pfeuh/yass/doc/electronicCao/docs/boite/yass_box.jpg

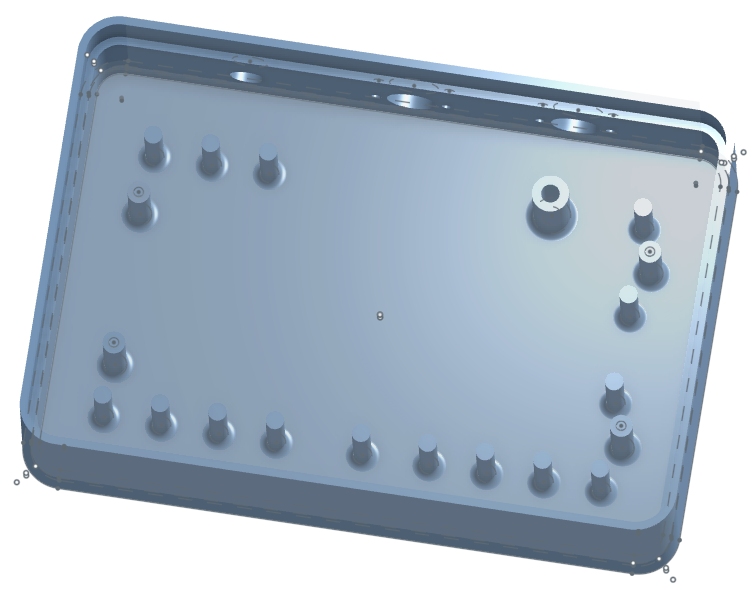
doc/electronicCao/docs/boite/yass_box.jpg
