pfeuh/yass/doc/img/yassWhiteFace.JPG

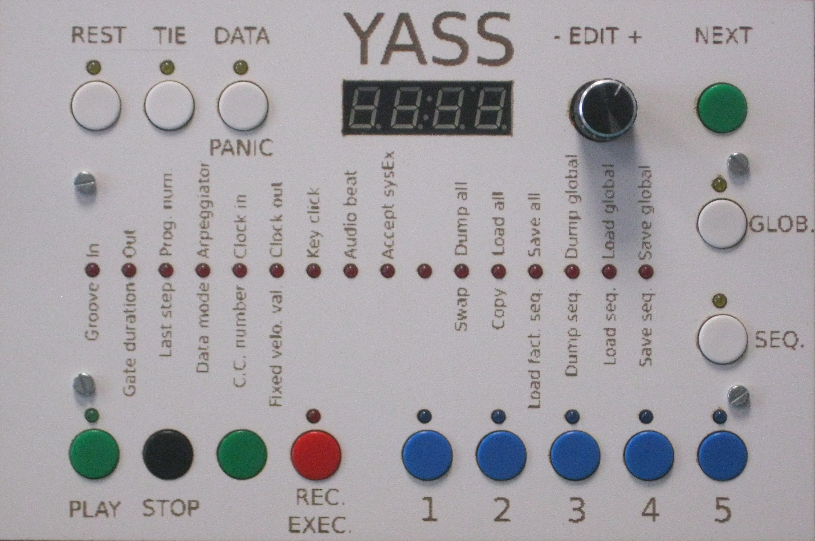
doc/img/yassWhiteFace.JPG
