pfeuh/yass/doc/readme.txt

Concerning Yass, all is shared.

Box data is explaned in yassBox.txt.
Schematic is in this folder.
To make the PCB, data is in fab folder.
