pfeuh/yass/doc/configuration.pdf

configuration

Page 1

| FONCTION | RANGE
GLOBAL | 1 In
| 2 Out
| 3

### 4 Off-On 5 Off-On 6 Off-On 7 Off-On 8 Off-On

| 9 Use exclusive | Off-On
| 10
| 11
| 12
| 13
| 14
| 15
| 16
SEQUENCE | 1 Groove | [1:7]
2 [1:3]
3 [1-16]
| 4 Data mode | [1-3]
| 5
| 6
| 7
| 8
| 9
| 10
11 [1:5]
| 12 Swap | [1:5]
| 13
14 [1:5]
15 [1:5]
16 [1:5]

Mode DEBUG

omni-[1 :16]
[1 :16]
Program number | [0 :127]-none
Sequencer/Arpeggiator
Clock in
Clock out
Key echo
Click
Dump project | work area or [1:xx]
Load project | work area or [1:xx]
Save project | work area or [1:xx]

Gate mode
Last step
Control change number | [1 :127]
Fixed velocity value | [1 :127]

Copy

Load from factory | [1:xx]
Dump sequence
Load sequence
Save sequence

Return to factory

configuration

Page 2

COMMENT

4, 8, 8t, 8 swing, 16, 16t, 16swing

Démarrer avec seq1 et seq5 appuyés

Number of projets not known at the moment Number of projets not known at the moment Number of projets not known at the moment

Short, regular, long

velocity, control change, fixed velocity

Destination value is memorized for next call Destination value is memorized for next call
xx depends on how many sequences are in ROM default value of selector is current sequence number default value of selector is current sequence number default value of selector is current sequence number

Démarrer avec seq 4 et seq5 appuyés
