pfeuh/yass/doc/electronicCao/boite/fixation face avant.pdf

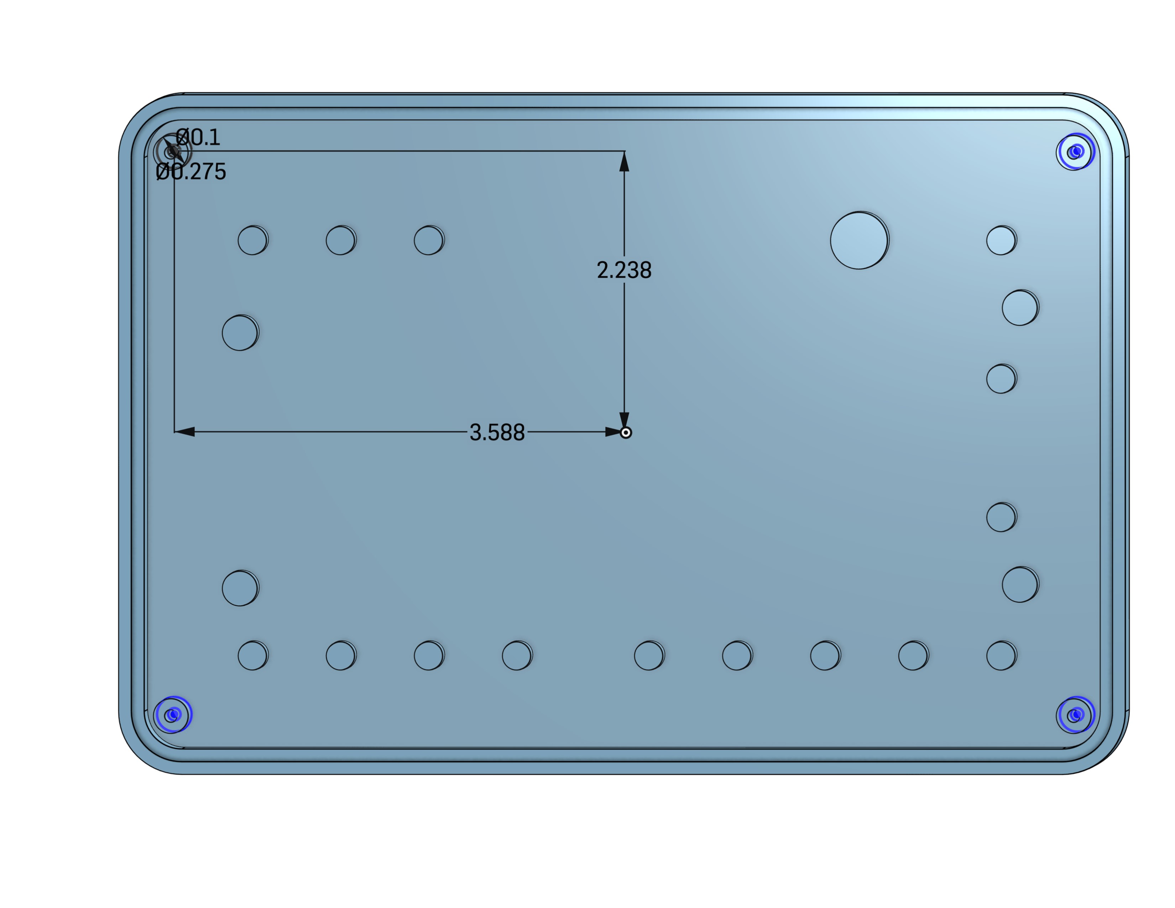
[picture p4: page 1]
