pfeuh/yass/doc/electronicCao/boite/fond.pdf

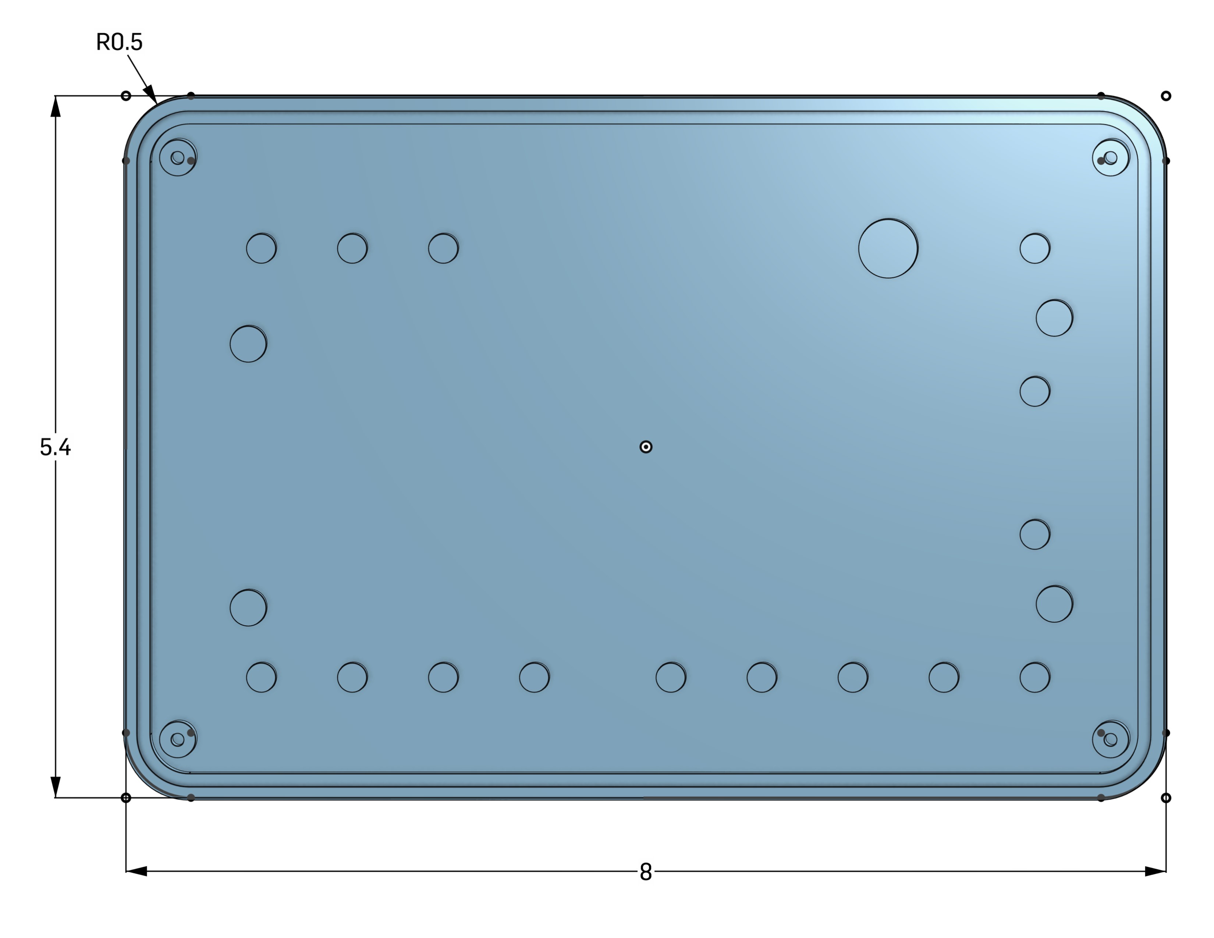
[picture p5: page 1]
