pfeuh/yass/doc/electronicCao/boite/supports_boutons.pdf

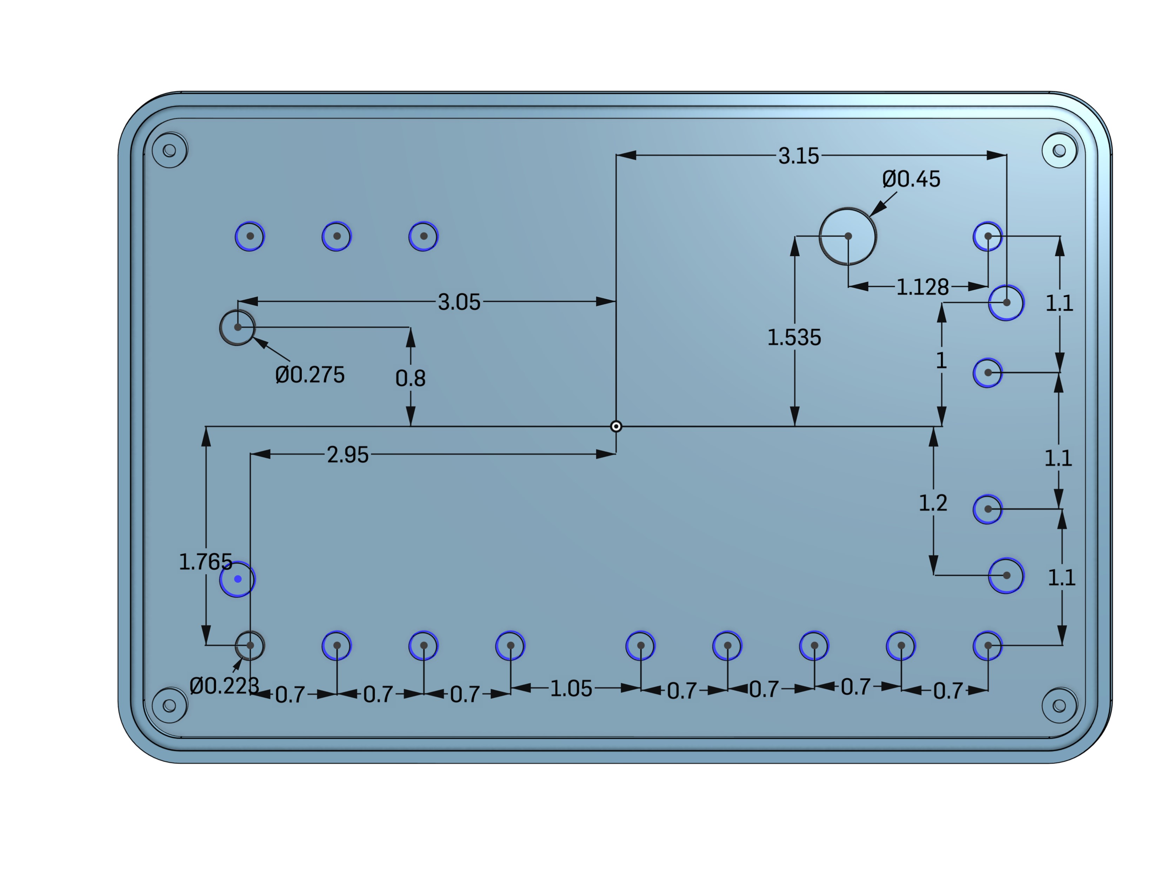
[picture p6: page 1]
