pfeuh/yass/doc/electronicCao/boite/bottom/dimensions.pdf

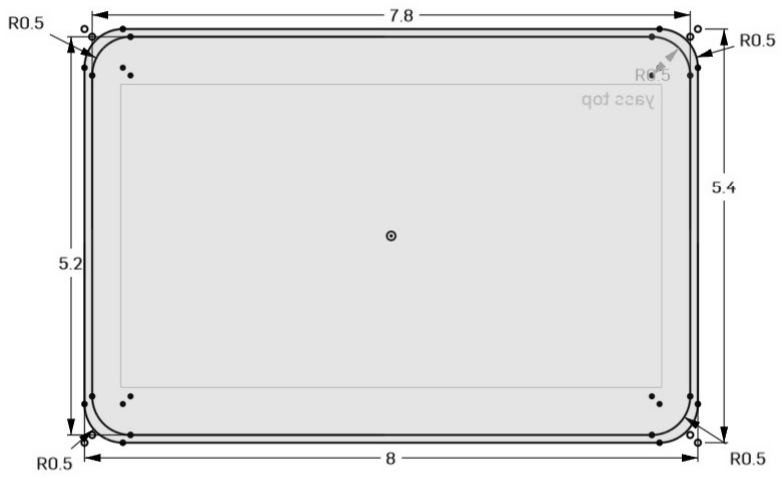
[picture p7: figure]
