pfeuh/yass/doc/electronicCao/boite/bottom/yass_bottom_cotes.pdf

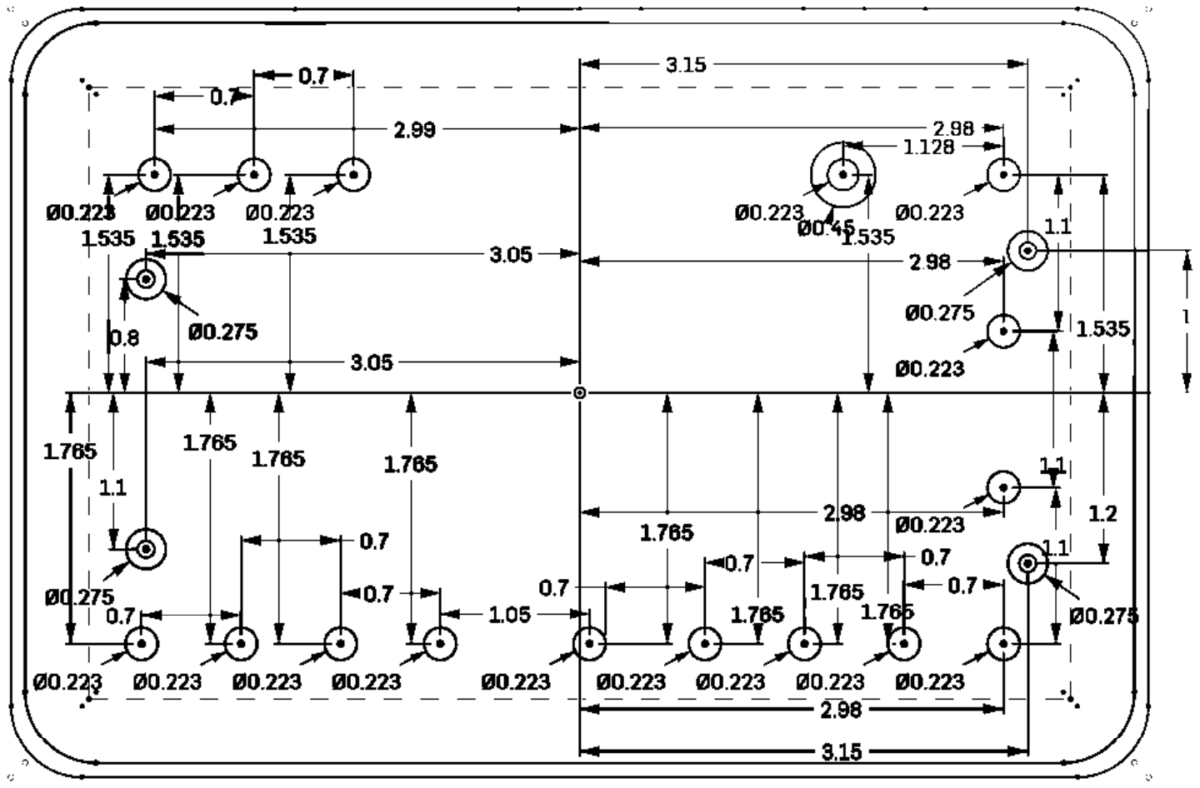
[picture p8: page 1]
