pfeuh/yass/doc/electronicCao/boite/key/main.pdf

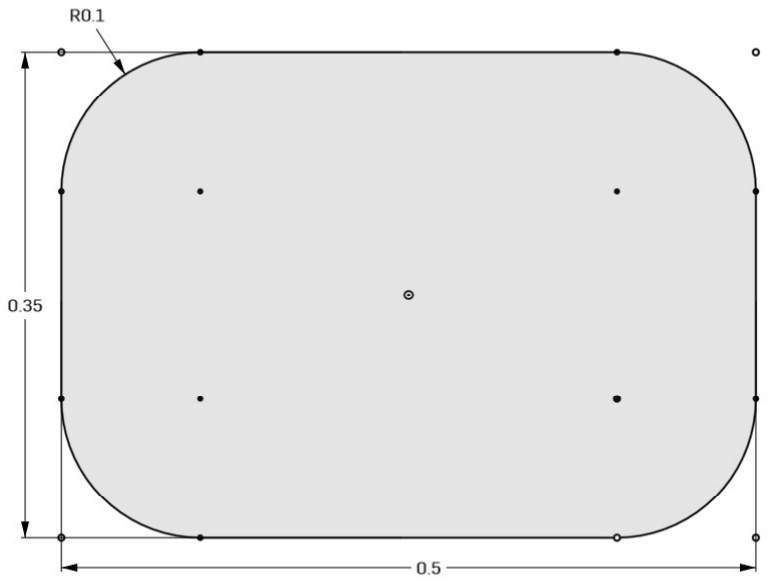
[picture p9: figure]
