pfeuh/yass/doc/electronicCao/boite/key/support.pdf

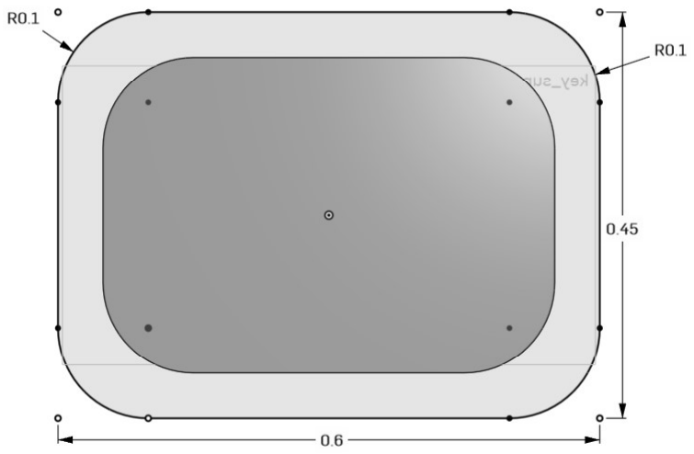
[picture p10: figure]
