pfeuh/yass/doc/electronicCao/boite/bottom/Image1.bmp

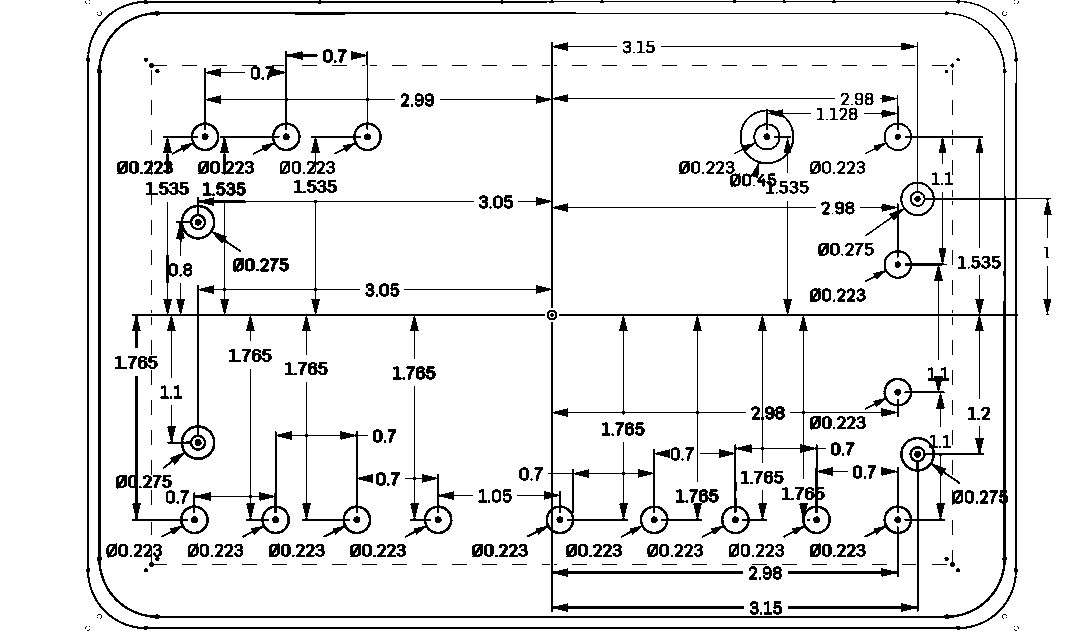
doc/electronicCao/boite/bottom/Image1.bmp
