pfeuh/yass/doc/electronicCao/boite/key/main.bmp

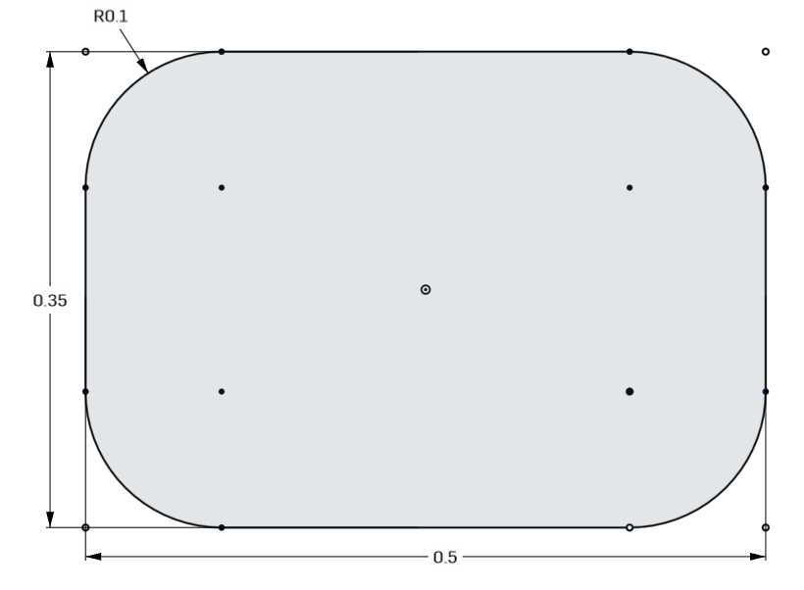
doc/electronicCao/boite/key/main.bmp
