pfeuh/yass/doc/electronicCao/boite/key/support.bmp

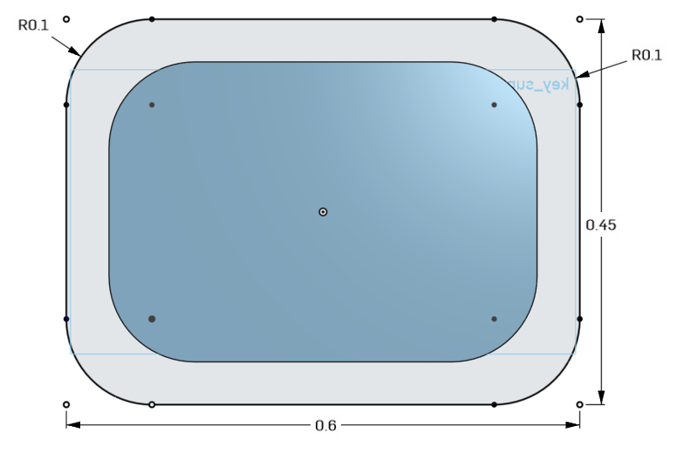
doc/electronicCao/boite/key/support.bmp
