pfeuh/yass/doc/electronicCao/docs/boite/yass_buttons.jpg

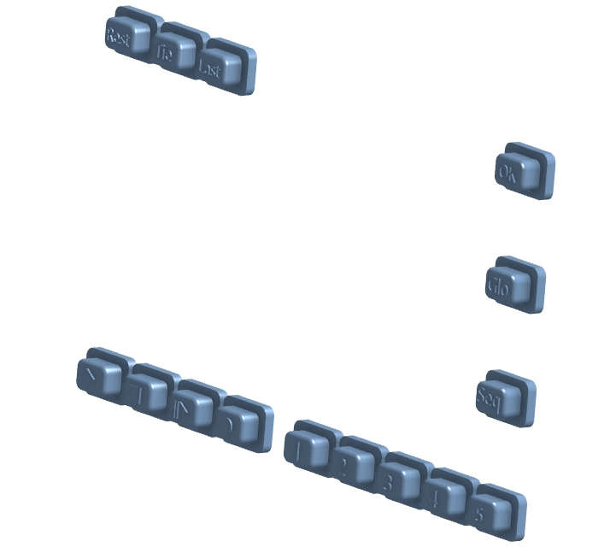
doc/electronicCao/docs/boite/yass_buttons.jpg
