pfeuh/yass/doc/electronicCao/docs/boite/yass_front_pannel.jpg

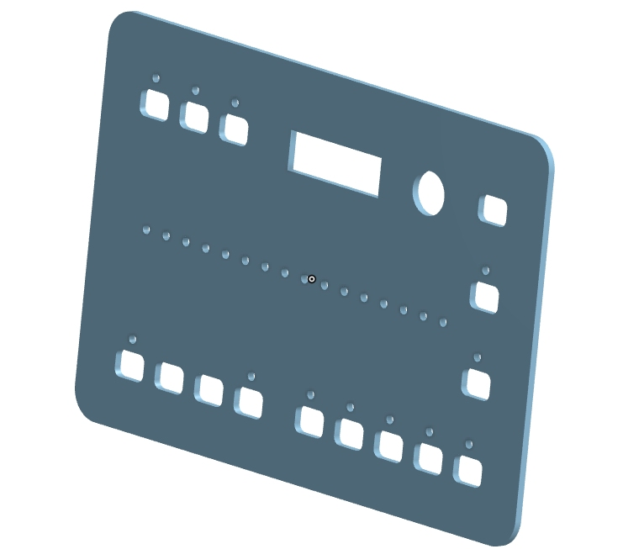
doc/electronicCao/docs/boite/yass_front_pannel.jpg
