pfeuh/yass/doc/frontPannel/inkscapeSvgcode/finalSeriagraphie.png

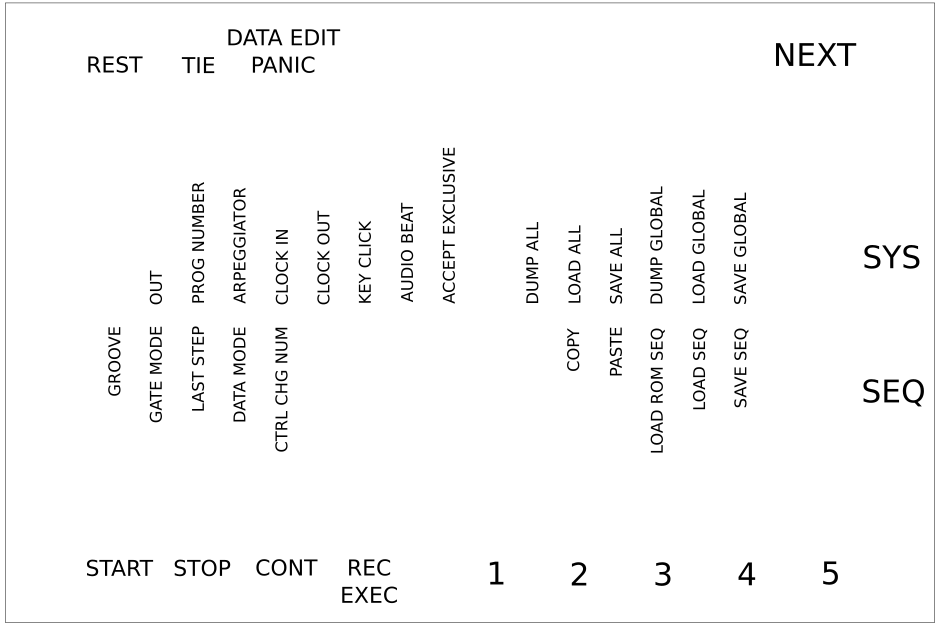
doc/frontPannel/inkscapeSvgcode/finalSeriagraphie.png
