pfeuh/yass/doc/frontPannel/scriptSvg/img/panneauDeControle.bmp

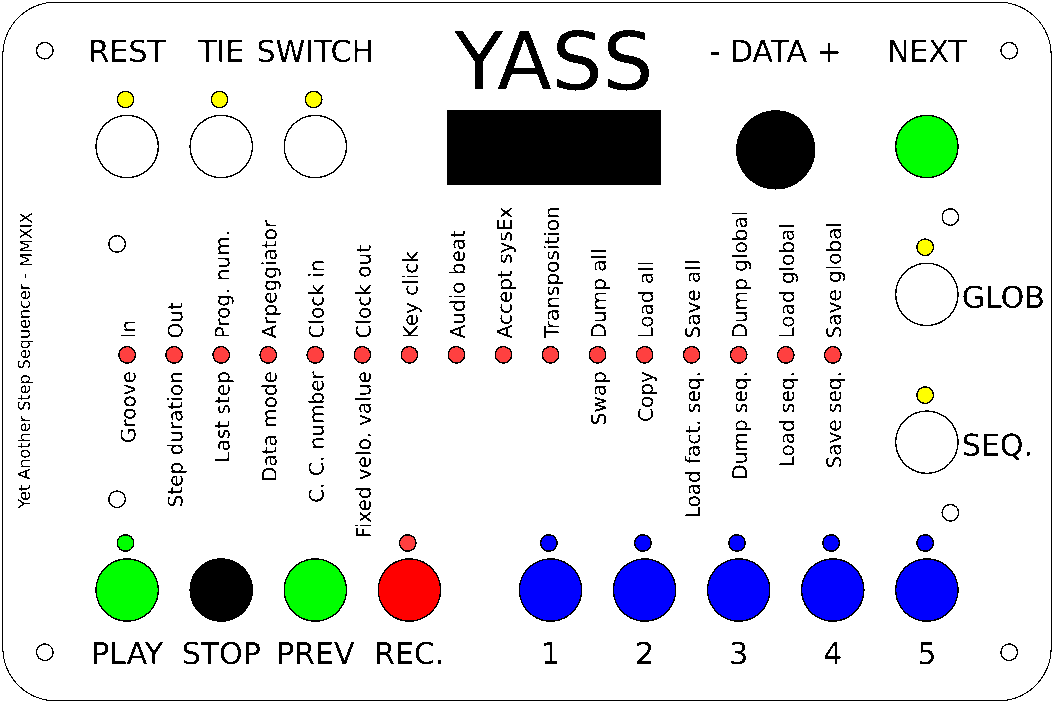
doc/frontPannel/scriptSvg/img/panneauDeControle.bmp
