pfeuh/yass/doc/frontPannel/simulation/img/yass_pannel.gif

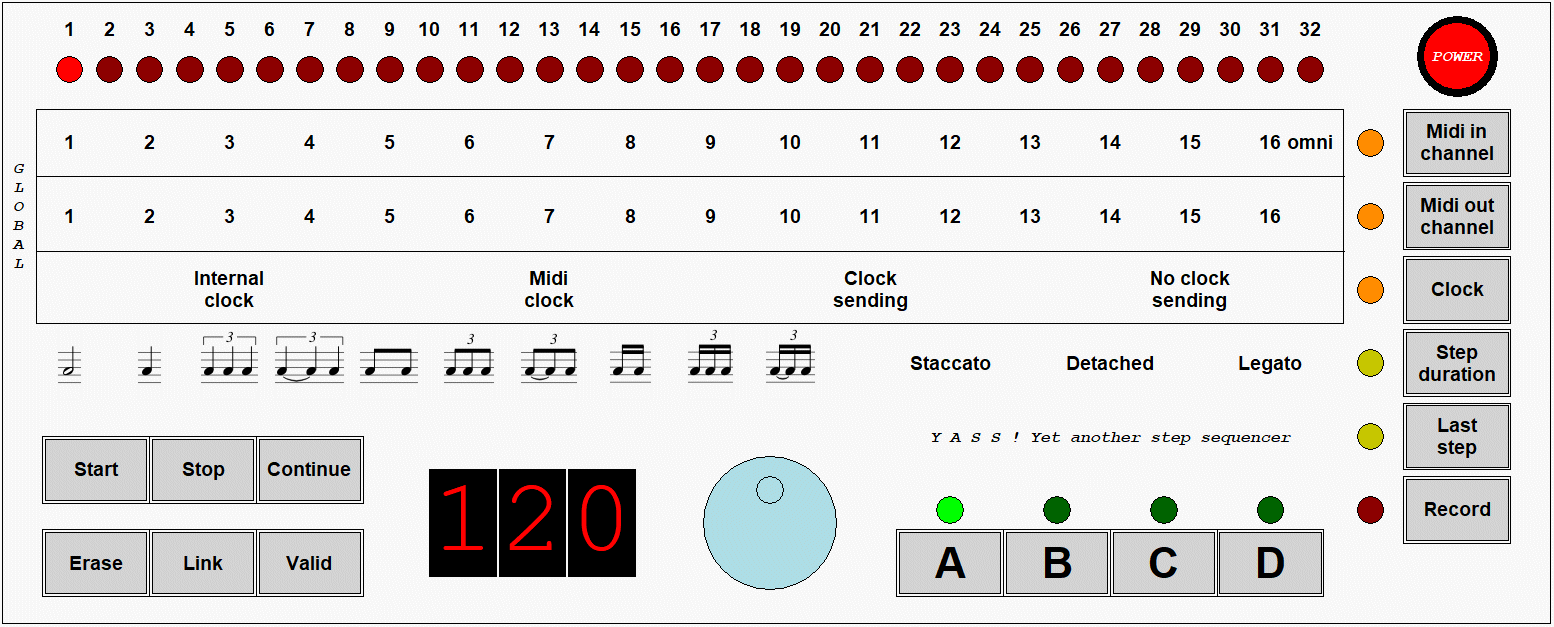
doc/frontPannel/simulation/img/yass_pannel.gif
