pfeuh/yass/doc/frontPannel/simulation/img/yassFrontPanel.jpg

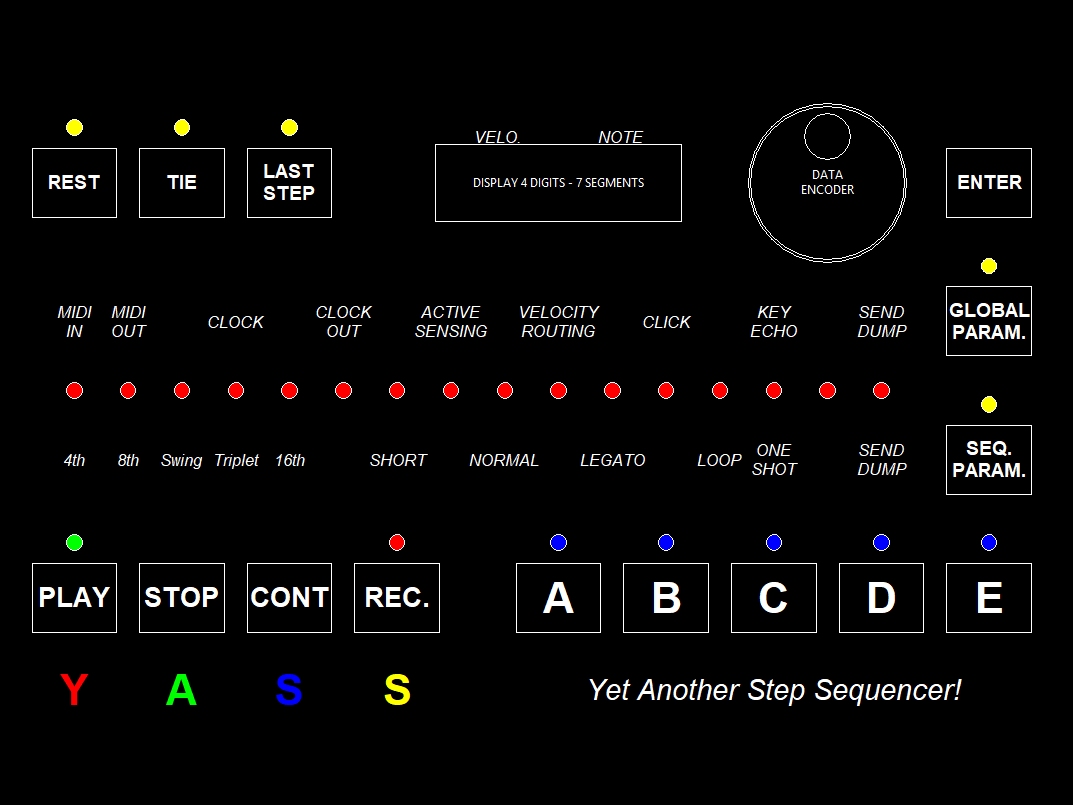
doc/frontPannel/simulation/img/yassFrontPanel.jpg
