pfeuh/yass/doc/3D_objects/yassBoxV2.stl

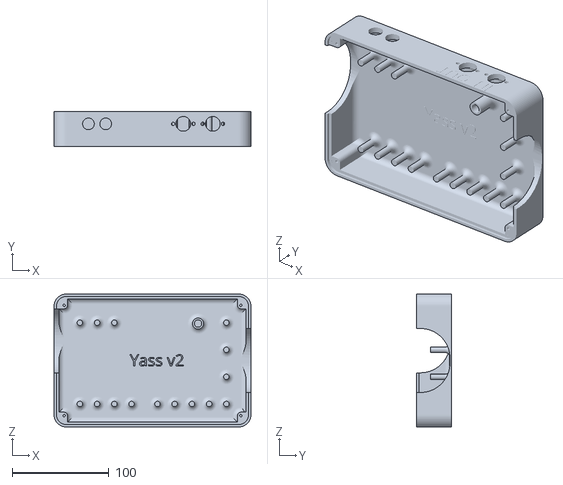
[picture p20: CAD file, 2019-09-08]
doc/3D_objects/yassBoxV2.stl
203.2 x 36.0 x 137.2
