pfeuh/yass/doc/electronicCao/boite/yass_box_bottom.stl

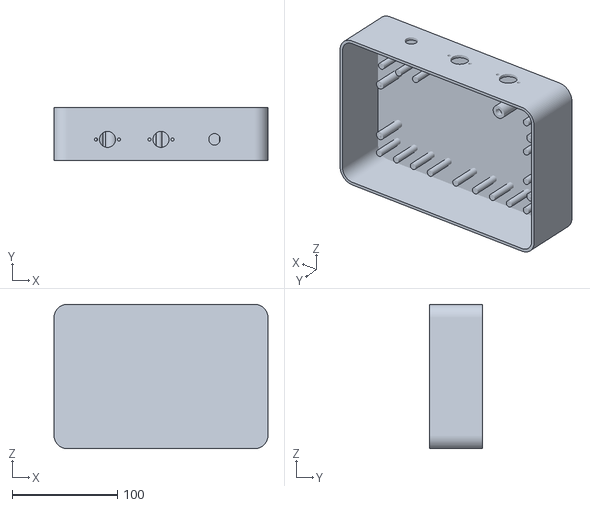
[picture p21: CAD file, 2019-09-05]
doc/electronicCao/boite/yass_box_bottom.stl
203.2 x 50.8 x 137.2
