pfeuh/yass/doc/electronicCao/docs/boite/yass_key.stl

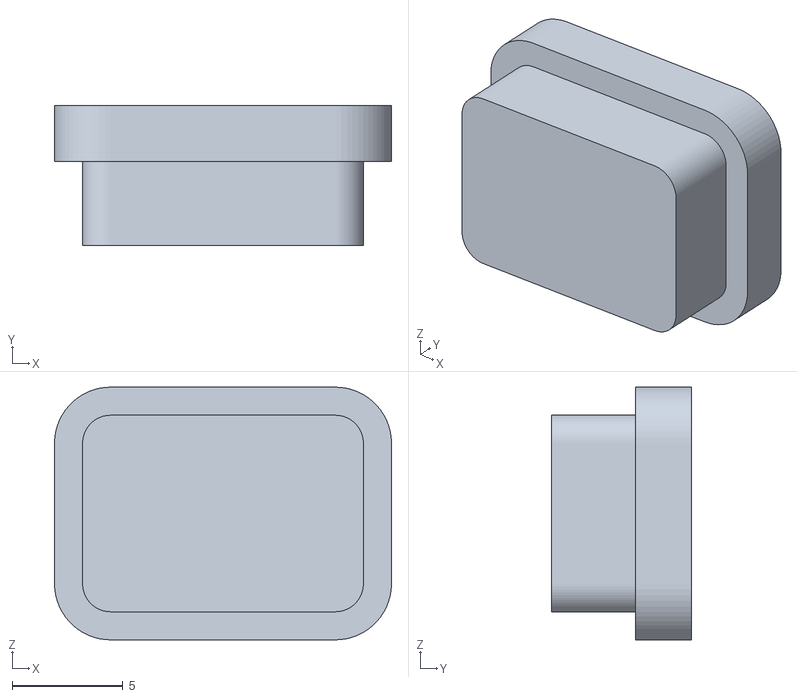
[picture p22: CAD file, 2019-09-05]
doc/electronicCao/docs/boite/yass_key.stl
15.2 x 6.35 x 11.4
