pfeuh/yass/doc/3D_objects/yassFrontPannelV2.stl

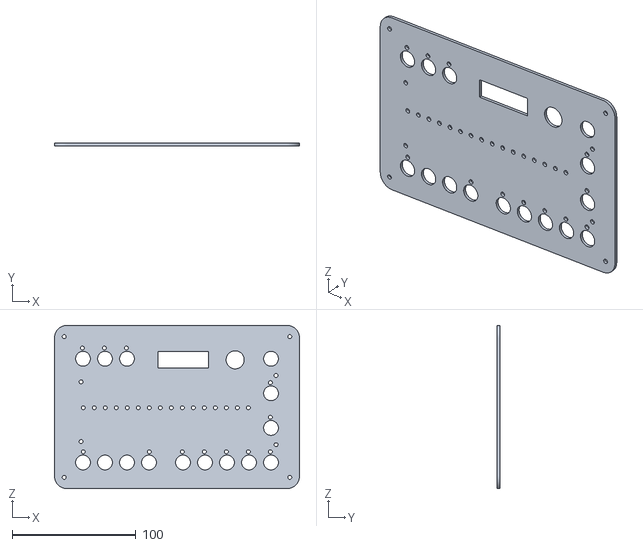
[picture p23: CAD file, 2019-09-08]
doc/3D_objects/yassFrontPannelV2.stl
197.9 x 2.03 x 131.9
