pfeuh/yass/doc/electronicCao/docs/boite/yass_box_top.stl

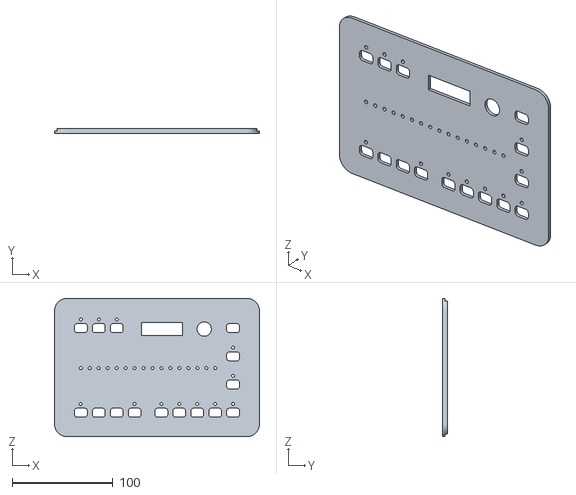
[picture p24: CAD file, 2019-09-05]
doc/electronicCao/docs/boite/yass_box_top.stl
203.2 x 5.08 x 137.2
