pfeuh/yass/doc/3D_objects/yassEntretoises.stl

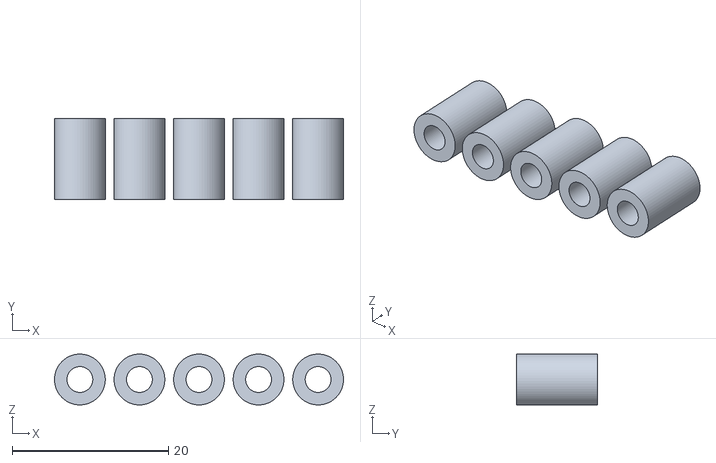
[picture p25: CAD file, 2019-09-05]
doc/3D_objects/yassEntretoises.stl
37.0 x 10.4 x 6.50
