pfeuh/yass/doc/3D_objects/yassTails.stl

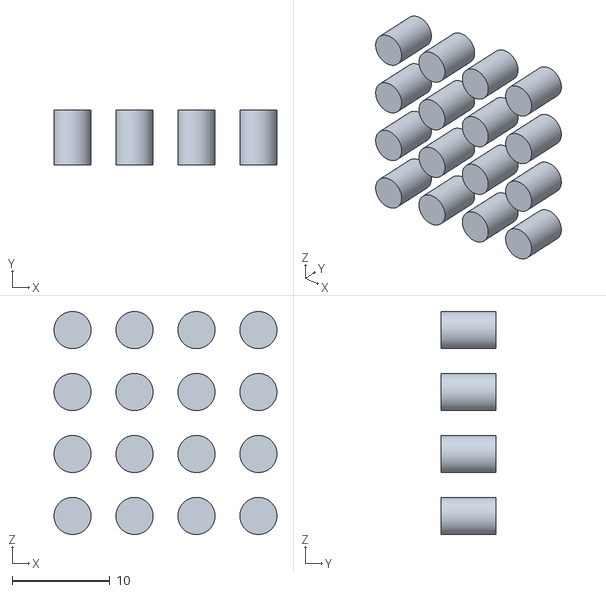
[picture p26: CAD file, 2019-09-05]
doc/3D_objects/yassTails.stl
22.9 x 5.59 x 22.9
