pfeuh/yass/doc/3D_objects/yassBoxV1.stl

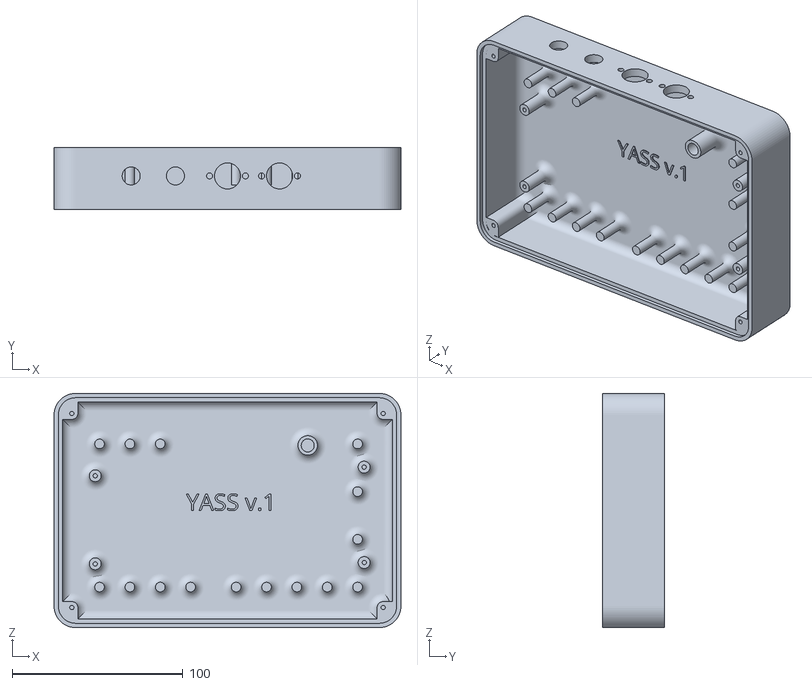
[picture p27: CAD file, 2019-09-05, an earlier design]
doc/3D_objects/yassBoxV1.stl
203.2 x 36.0 x 137.2
