pfeuh/yass/(list of files, cad)

Other CAD files:
doc/3D_objects/CE3_yassBoxV2.3mf
