pfeuh/yass/doc/userManual.odt

Yass

Mode d'emploi


# Qu’est que le YASS ?

YASS est un acronyme pour Yet Another Step Sequencer (Encore un autre séquenceur pas à pas). C’est un séquenceur, c'est à dire est un montage permettant de jouer en boucle une séquence de notes… En midi, bien sûr, c’est à dire qu’il ne joue rien du tout mais pilote des machines capables de le faire.

Le YASS peut enchaîner 5 séquences différentes au gré de l’utilisateur. Sa particularité, au vu des milliers de séquenceurs qui existent sur le marché, est son interface homme machine très typée années soixante-dix.

## Caractéristiques

- Microcontrôleur embarqué Arduino Nano.
- Midi in Oui.
- Midi out Oui.
- Horloge midi extérieure acceptée Oui.
- Horloge midi interne Oui.
- Horloge midi envoyée Oui.
- Transposition des séquences par clavier Oui.
- sauvegarde en eeprom Oui.
- sauvegarde en system exclusive Oui.
- Nombre de séquences 5.
- Nombre max de pas par séquence 16.
- Tempo De 55 à 280 BPM.
- Résolution 1 / 24ème de noire.
- Débits Noire, croche, triolet de croche, croches swinguées, double croche, triolet de double croche, double croche swinguées.
- Durée de note 90%, 70% et 50%.
- Control change Un seul à la fois, pas d'autre restriction.
- Enregistrement Pas à pas uniquement.
- Temps de cycle Inférieur à 1 millisconde.

# Panneau de contrôle


## Touches

Sélection de séquence 1 Sélection de la séquence 1. 2 Sélection de la séquence 2. 3 Sélection de la séquence 3. 4 Sélection de la séquence 4. 5 Sélection de la séquence 5. Transport PLAY Jouer/Mettre en pause. STOP Arrêter. REC. Enregistrer. | Navigation NEXT Aller au paramètre suivant. PREV Aller au paramètre précédent. Paramétrage GLOB Paramétrage global. SEQ. Paramétrage séquence courante. Edition enregistrement REST Transformer note en silence. TIE Lier la note à la précédente. SWITCH Basculer de la note à sa donnée.

Les 16 leds rouges qui forment une ligne horizontale au milieu du panneau ont plusieurs fonctions:

- Indiquer le numéro de pas actuel de la séquence en cours d'exécution.
- Indiquer le nom du paramètre global en cours d'édition.
- Indiquer le nom du paramètre de séquence en cours d'édition.
- Indiquer le numéro de la note en cours d'édition (en enregistrement pas à pas).

# Paramétrage global

Quand on passe en mode paramétrage global, la led de la touche GLOB s'allume pour indiquer qu'on est en mode paramétrage global. Un des 16 leds de pas s'allume pour désigner le paramètre en cours d'édition. Le nom de ce paramètre est le texte vertical au dessus de la led de pas. Tous les paramètres s'éditent grâce à l'encodeur et la valeur du paramètre est affichée sur le display. On passe d'un paramètre à un autre grâce aux touches NEXT et PREV.

- In Choisir le canal midi en entrée (mode omni ou canal 1 à 16).
- Out Choisir le canal midi en sortie (canal 1 à 16).
- Prog. Num. Choisir le programe (voice). None (rien) ou de 1 à 128.
- Arpeggiator Activer le mode arpégiateur (au lieu du mode séquenceur).
- Clock in Activer le mode esclave (piloté par le midi in).
- Clock out Envoyer l'horloge sur le midi out.
- Key click Génèrer un beep de retour de touche sur le buzzer.
- Audio beat Génèrer un métronome sur le buzzer.
- Accept sysEx Activer la réception des dumps sur le midi in.
- Transposition Choisir la transposition des notes du midi in (de -128 à +127).
- Dump all Envoyer un dump de la configuration globale et les 5 séquences.
- Load all Charger la configuration globale et les 5 séquences depuis l'eeprom.
- Save all Sauver la configuration globale et les 5 séquences en eeprom.
- Dump global Envoyer un dump de la configuration globale.
- Load global Charge la configuration globale depuis l'eeprom.
- Save global Sauver la configuration globale en eeprom.

# Edition de la séquence courante

Quand on passe en mode paramétrage de la séquence courante, la led de la touche SEQ. s'allume pour indiquer qu'on est en mode paramétrage de la séquence courante. Un des 16 leds de pas s'allume pour désigner le paramètre en cours d'édition. Le nom de ce paramètre est le texte vertical au dessous de la led de pas. Tous les paramètres se modifient grâce à l'encodeur et la valeur du paramètre est affichée sur le display. On passe d'un paramètre à un autre grâce aux touches NEXT et PREV.

- Groove Choisir le débit de note (noire, croche, triolet de croche, croches swinguées, double croche, triolet de double croche, double croche swinguée).
- Step duration Choisir la durée de note (courte, normale, longue).
- Last step Choisir le dernier pas (de 1 à 16).
- Data mode Choisir le mode de donnée (vélocité, control change ou vélocité fixe).
- C. C. number Choisir le numéro de control change qui va utiliser la donnée.
- Fixed velo. value Choisir la valeur de vélocité fixe.
- -------------------- Réservé à un usage futur.
- -------------------- Réservé à un usage futur.
- -------------------- Réservé à un usage futur.
- Initialize initialise la séquence courante avec choix d'une note de remplissage.
- Swap Intervertir la séquence courante et une autre (de 1 à 5).
- Copy Copier la séquence courante sur une autre (de 1 à 5).
- Load fact. Seq. Copier une séquence d'usine sur la séquence courante.
- Dump seq. Envoyer un dump de la séquence courante.
- Load seq. Charger la séquence courante depuis l'eeprom.
- Save seq. Sauver la séquence courante en eeprom.

# Sélection de séquence

Quand on sélectionne une séquence (touches 1 à 5), sa led bleue correspondante s'allume pour indiquer quelle séquence est devenue la séquence courante. Si le séquenceur est en train de jouer, le changement ne se fera qu'au prochain pas numéro 1. Dans ce cas, la led de la séquence que l'on vient de sélectionner clignotera jusqu'au prochain pas numéro 1.

# Transport

## PLAY

Cette touche sert à démarrer, mettre en pause ou relancer le séquenceur. Quand le séquenceur tourne, la led de la touche PLAY est verte. Quand le séquenceur est en pause, elle est verte clignotante. Quand le séquenceur est à l'arrêt, elle est éteinte.

Quand le séquenceur est en pause (led verte clignotante) et que l'on appuie sur la touche PLAY, le séquenceur redémarre à l'endroit où on s'était mis en pause.

## STOP

Cette touche sert à arrêter le séquenceur. La led verte de la touche PLAY s'éteint. Après cela, si on redémarre, ce sera toujours au pas numéro 1 de la séquence courante.

## REC.

Cette touche sert a démarrer ou arrêter l'enregistrement pas à pas. Elle est indépendante des autres touches de transport : On peut l'utiliser avec le séquenceur à l'arrêt ou en marche.

Si on presse cette touche alors qu'on est en paramétrage, on quitte automatiquement le paramétrage.

Quand cette touche est clignotante, on est en mode paramétrage et on attend une validation pour exécuter une opération d'échange, de copie, de dump, de chargement ou de sauvegarde. Si on presse la touche, l'opération se fait. On peut abandonner en pressant NEXT, PREV, GLOB ou SEQ.

# Enregistrement

On passe en enregistrement en pressant la touche REC. On peut le faire indifférement avec la séquence qui tourne ou à l'arrêt. Si le séquenceur tourne, on voit toujours une led de pas allumée qui tourne de gauche à droite. Si on est à l'arrêt, la led du pas courant est allumée. Dans les deux cas, le pas en cours d'enregistrement clignote, sur la barre de leds de pas lui aussi.

On peut alors modifier la note et sa donnée en rentrant une note au clavier sur le midi in, modifier la note avec l'encodeur ou les boutons REST et TIE, modifer la donnée avec l'encodeur mais en ayant préalablement préssé le bouton DATA.

A tout moment, on peut avancer ou reculer dans la séquence grâce aux touches PREV et NEXT. Pour arrêter l'enregistrement, il suffit de presser REC. à nouveau,.

## REST

Cette touche sert à transformer la note en cours d'enregistrement pas à pas en silence, sa led devient alors jaune. Quand le séquenceur tourne et qu'il passe sur une note silencieuse, cette led s'allume jusqu'au pas suivant.

## TIE

Cette touche sert à lier la note en cours d'enregistrement pas à pas à la note précédente, sa led devient alors jaune. Quand le séquenceur tourne et qu'il passe sur une note liée, cette led s'allume jusqu'au pas suivant.

## SWITCH

Cette touche permet de passer de l'édition de la note en cours d'enregistrement pas à pas à l'édition de sa donnée associée. Cette donnée peut être la vélocité, la valeur d'un control change ou ne servir à rien en fontion du paramètre data mode de la séquence courante.

Cette touche sert aussi de touche PANIC, C'est à dire que quand on la presse (hors enregistrement) elle stoppe toutes les notes en train d'être jouées sur le canal midi de sortie du séquenceur.

Yass – Mode d'emploi - 7/7
