pfeuh/yass/doc/electronicCao/docs/YASS_v2.pdf

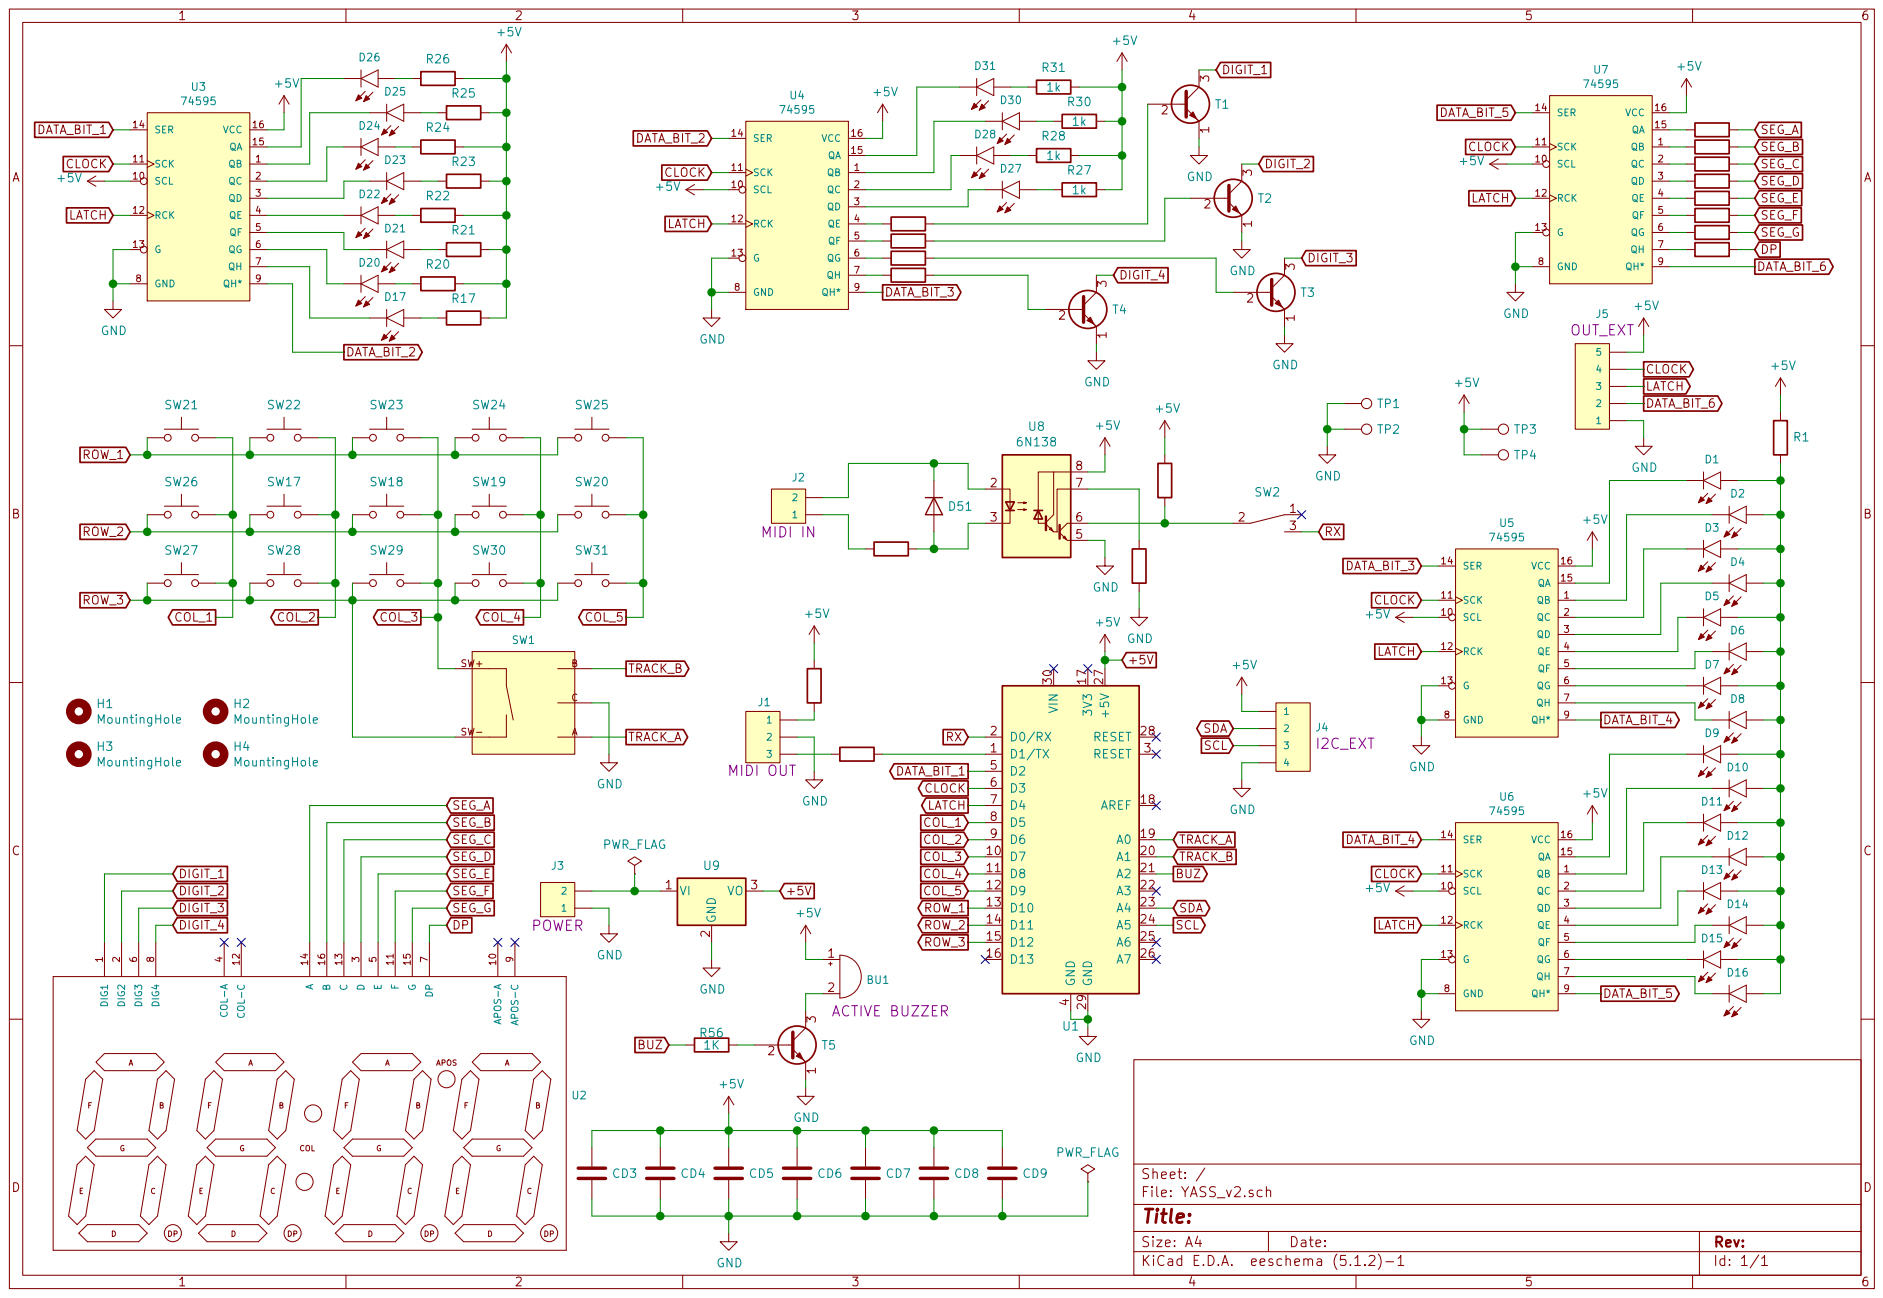
[picture p28: page 1]

3 T2 GND GND GND GND
