pfeuh/yass/doc/yassSchematic.pdf

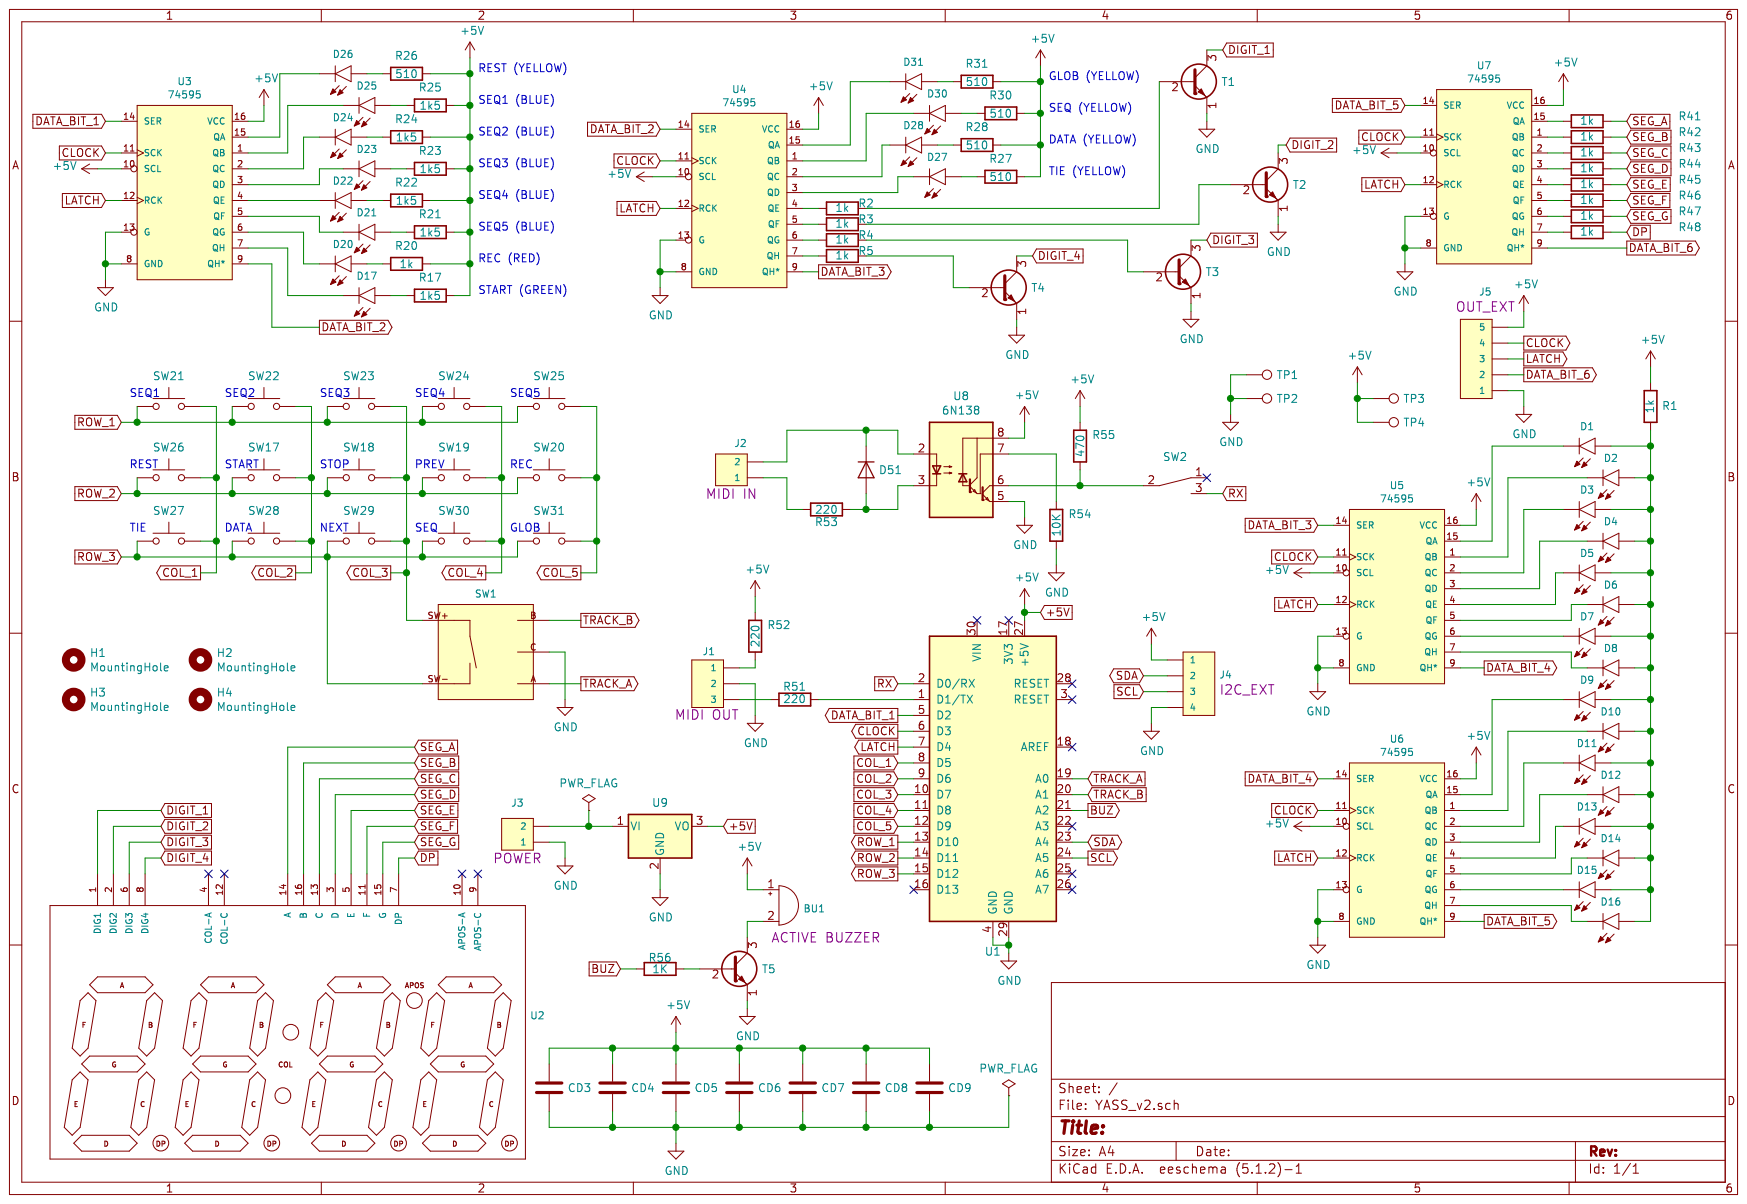
[picture p29: page 1]
