pfeuh/yass/doc/electronicCao/docs/dimensions.pdf

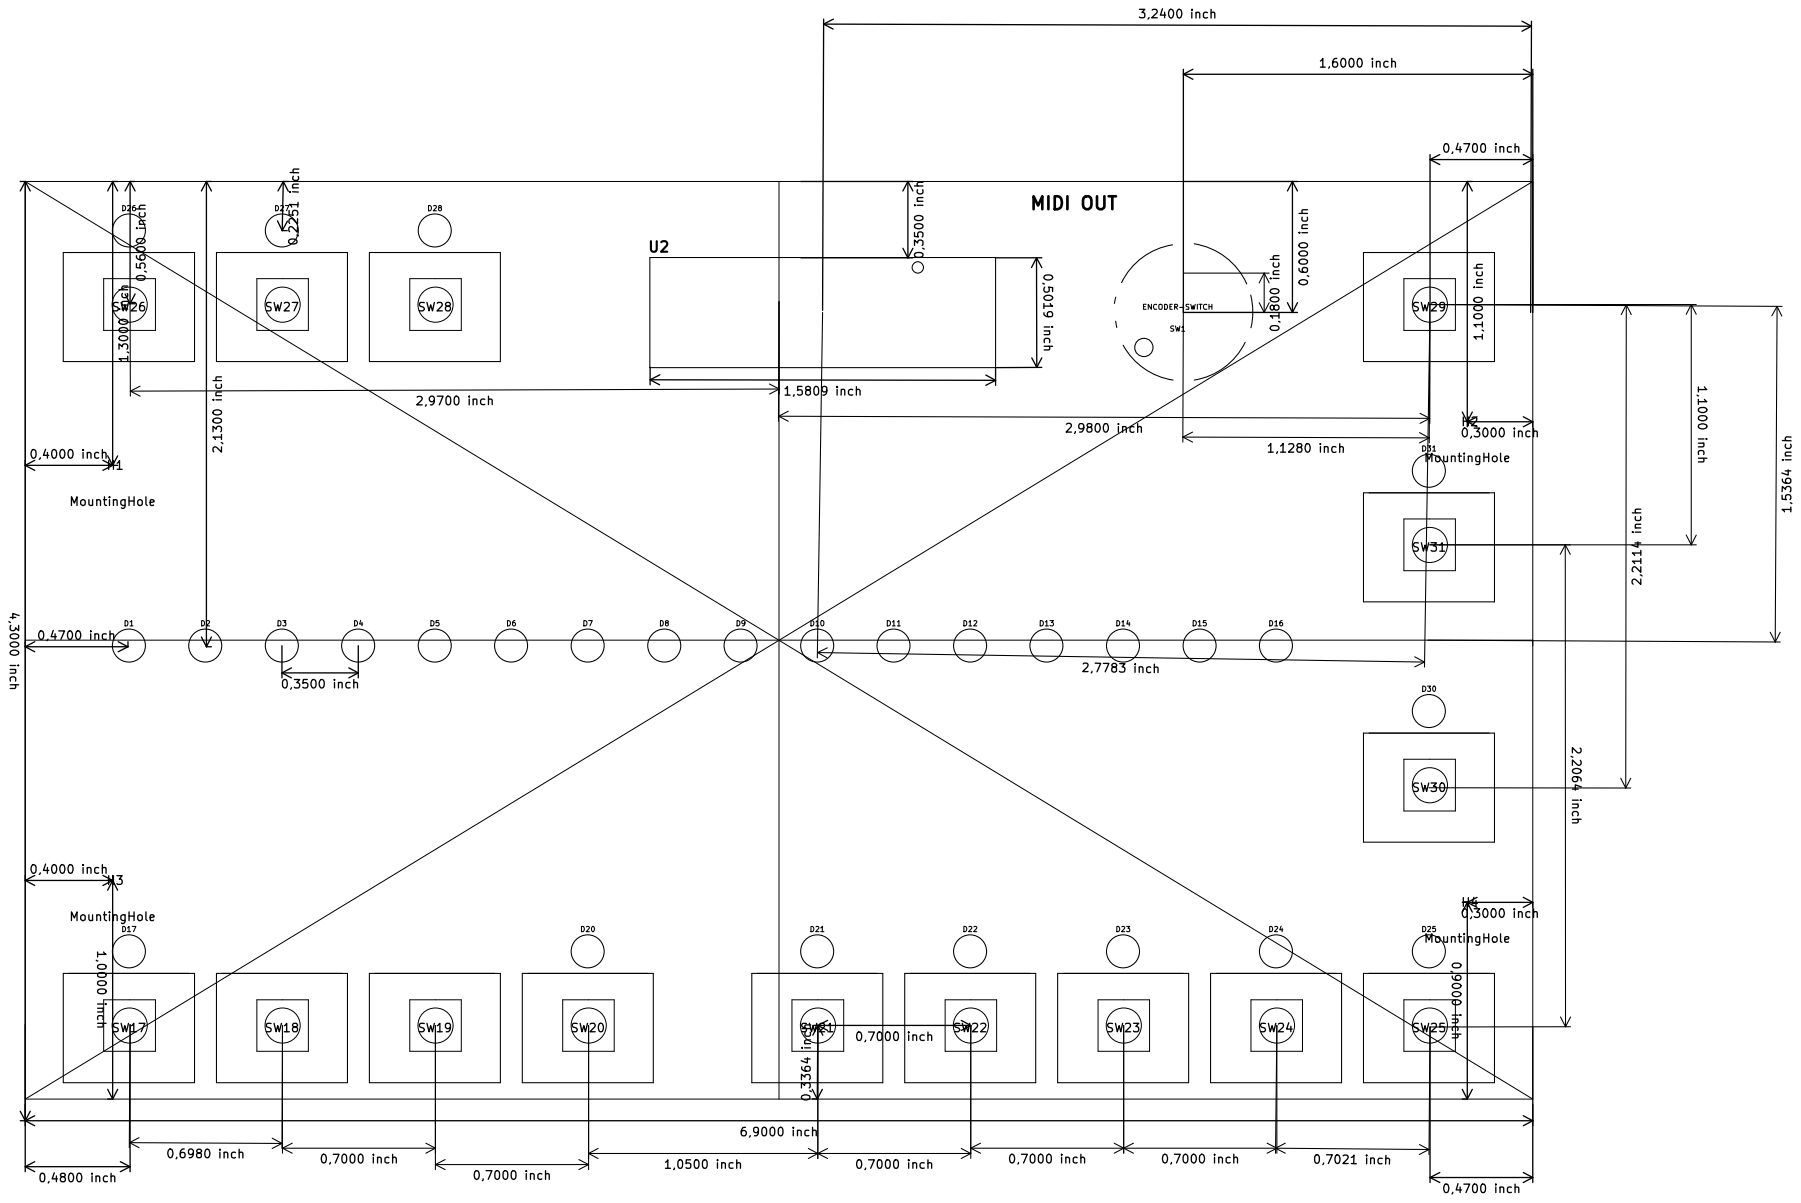
[picture p30: page 1]
