pfeuh/yass/doc/electronicCao/docs/supportsCarteDimensions.pdf

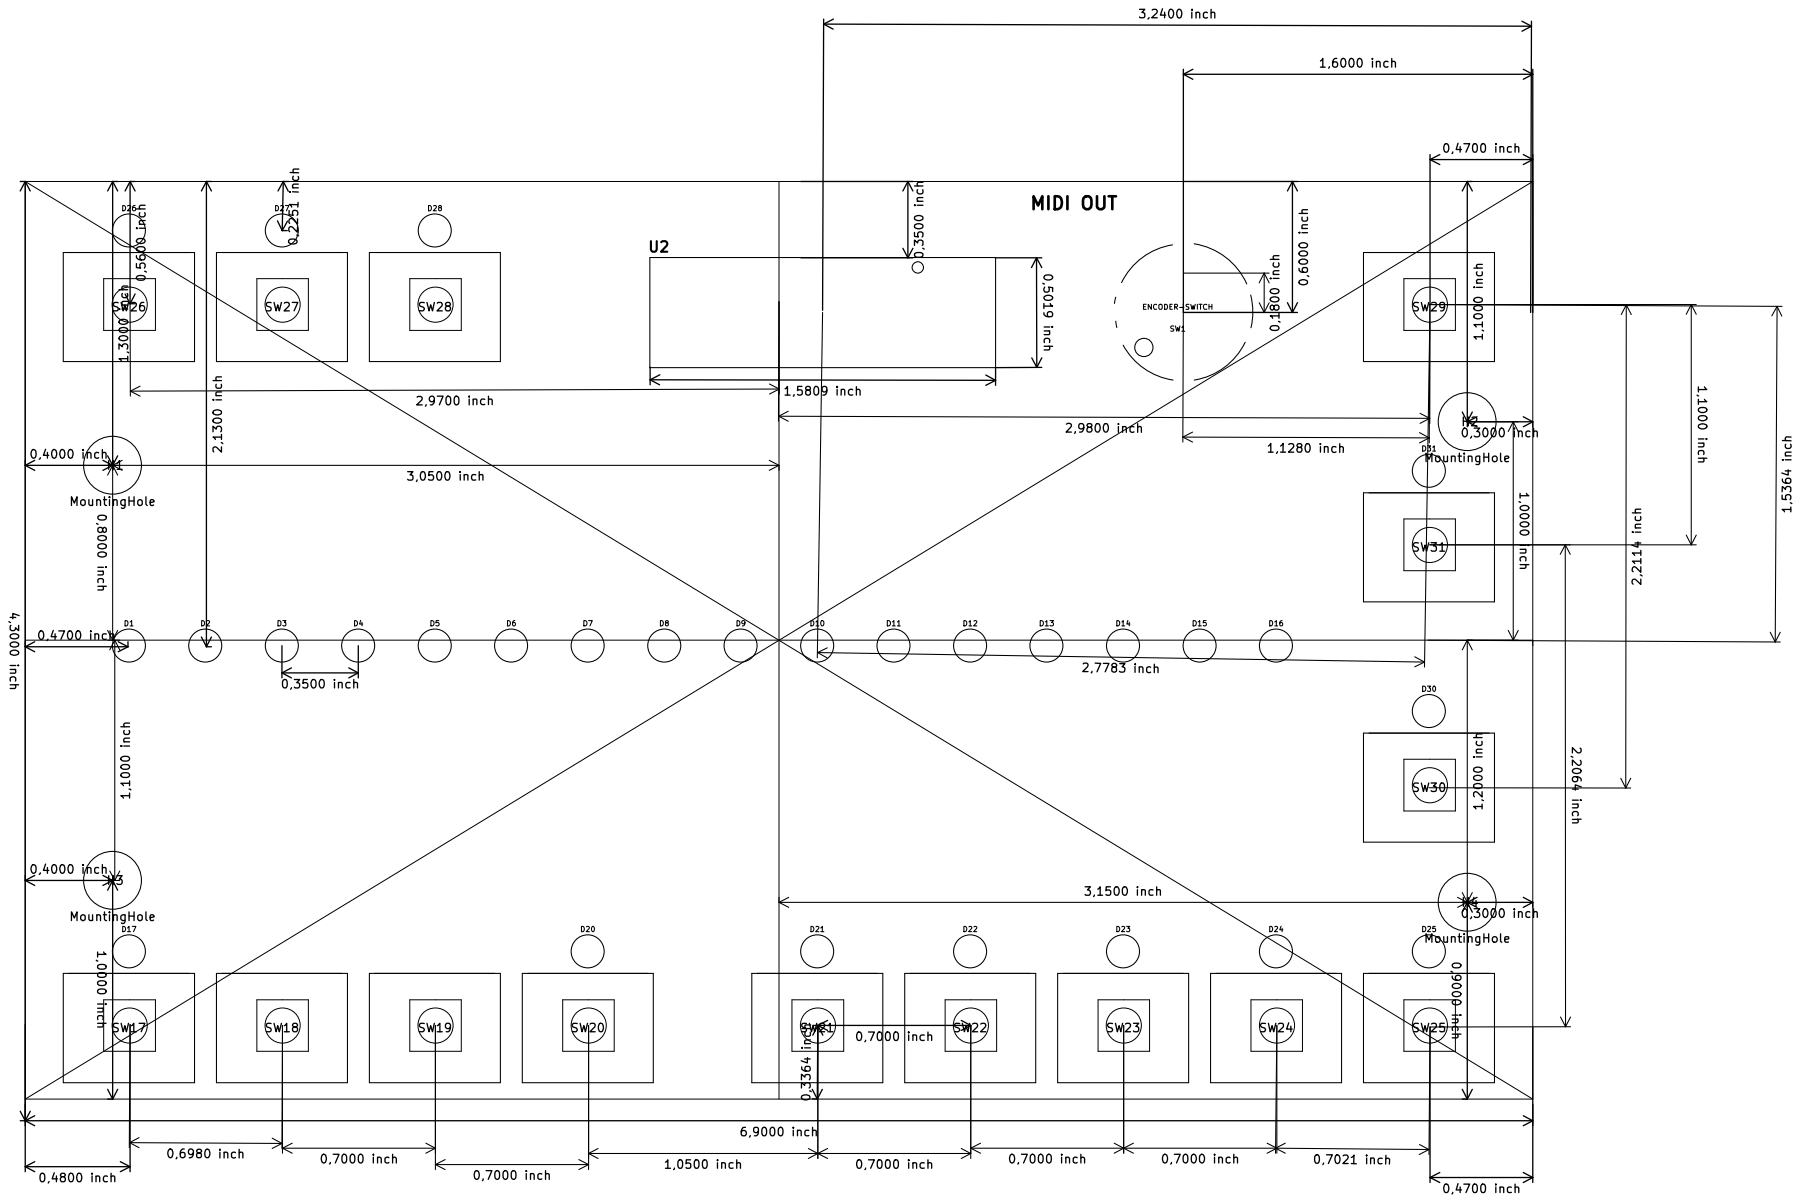
[picture p31: page 1]
