pfeuh/yass/doc/electronicCao/docs/yass_schematic.pdf

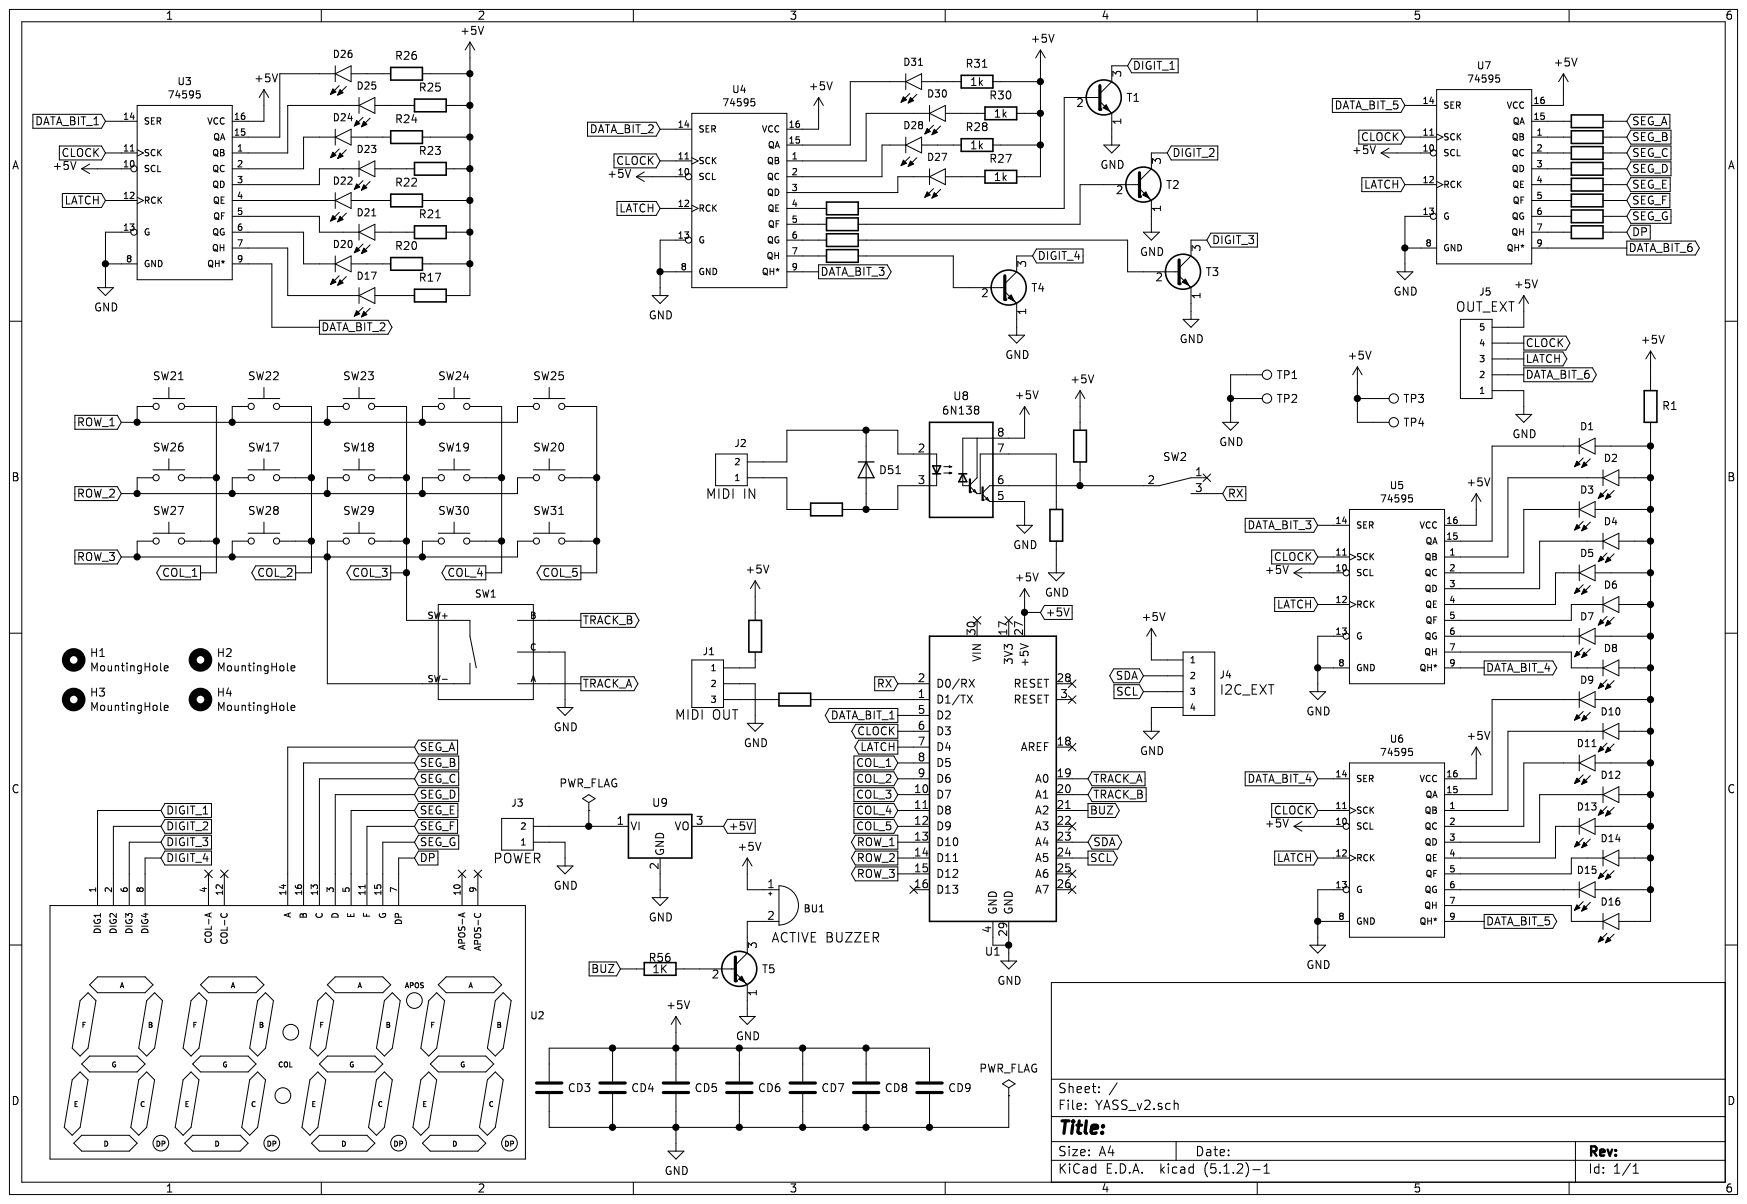
[picture p32: page 1]
