pfeuh/yass/doc/electronicCao/docs/yass_silk_top.pdf

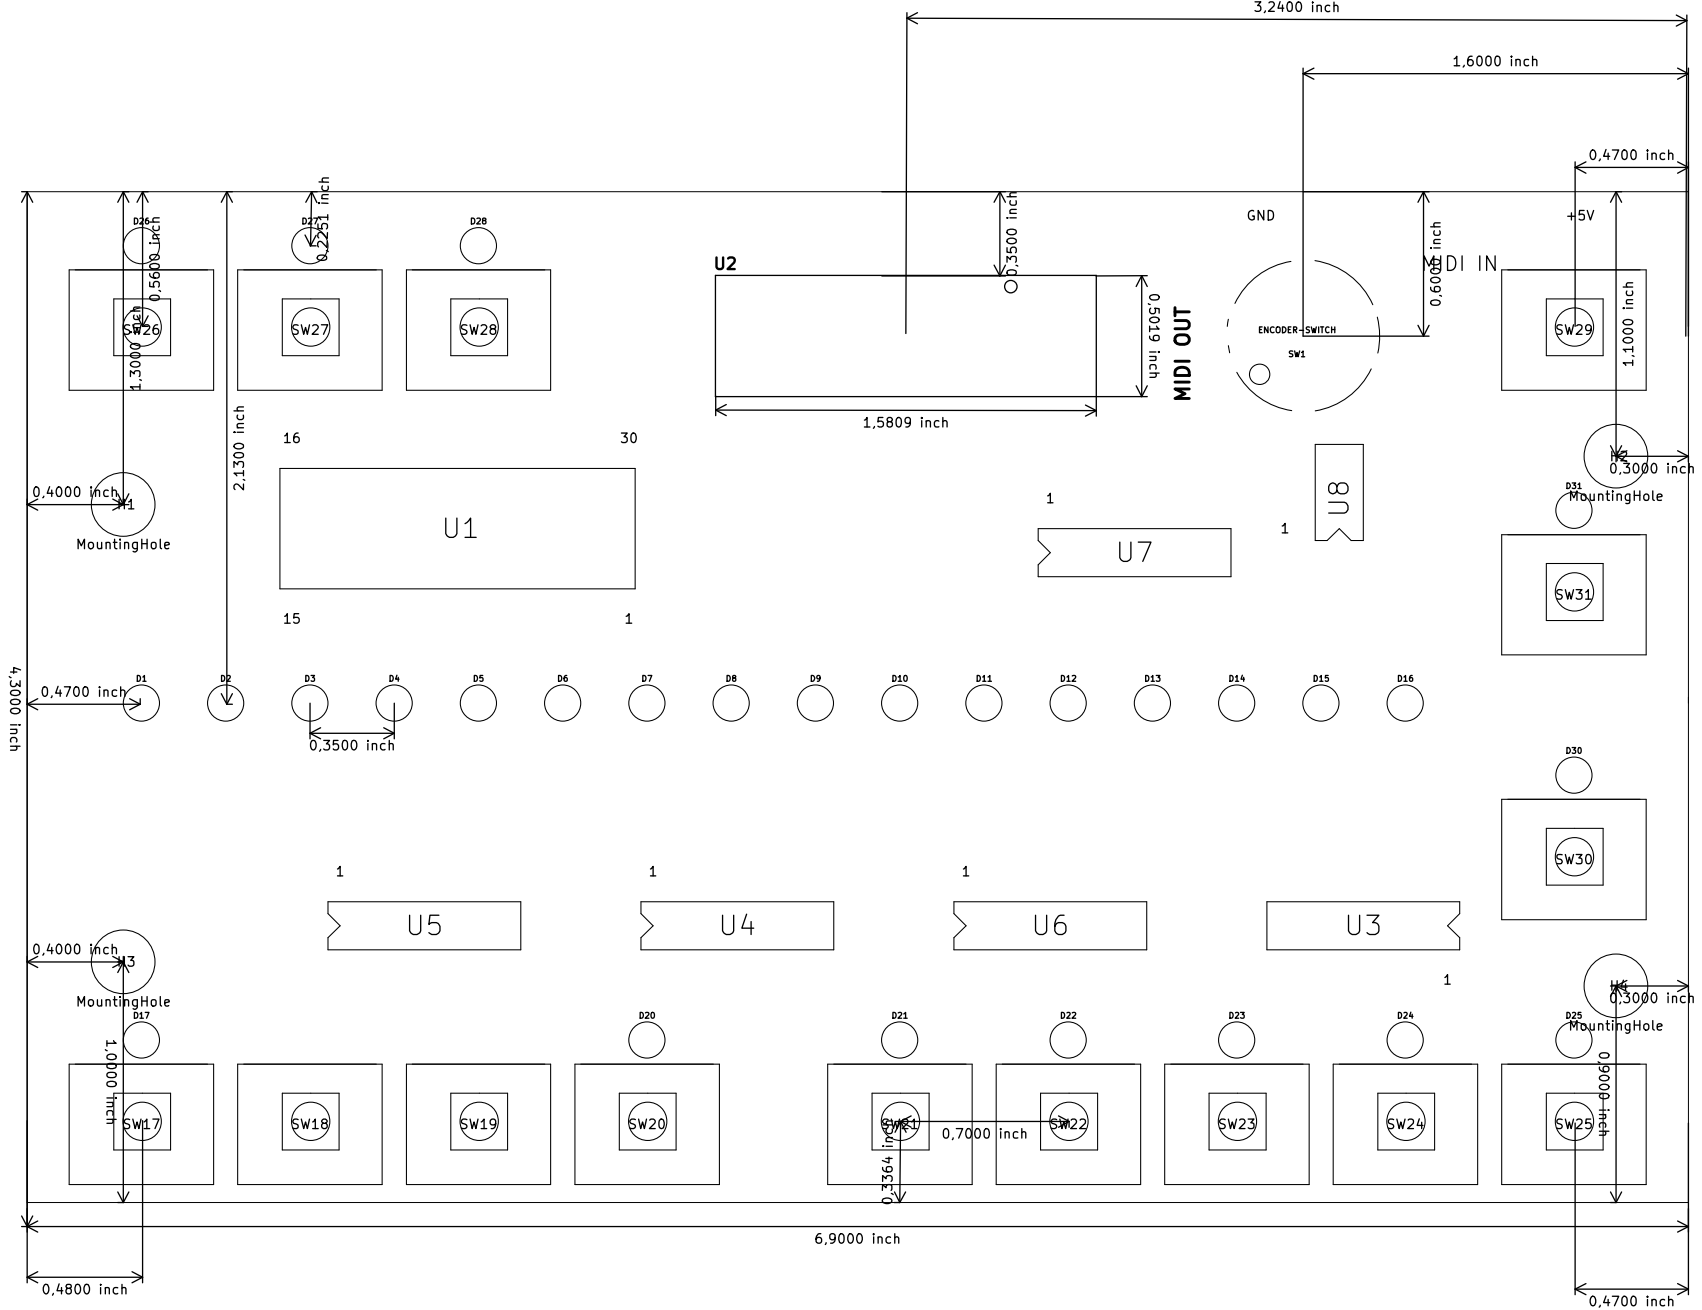
[picture p33: page 1]
