pfeuh/yass/doc/electronicCao/docs/YASS_v3-B_Cu.pdf

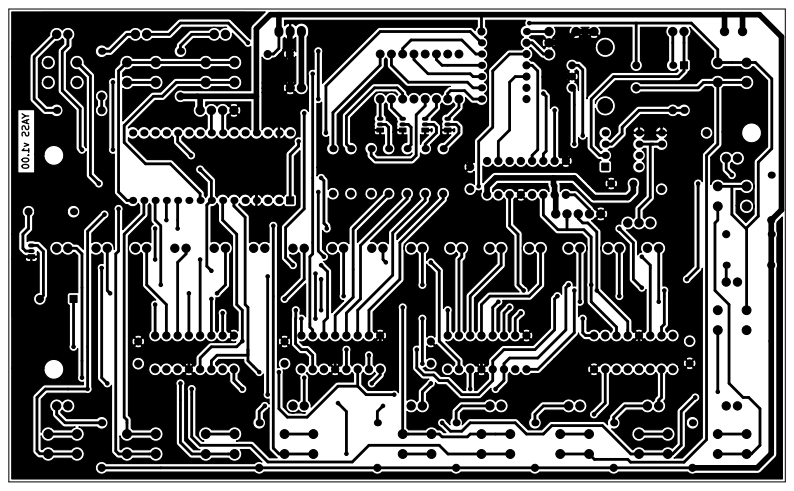
[picture p34: page 1]
