pfeuh/yass/doc/electronicCao/docs/YASS_v3-B_Mask.pdf

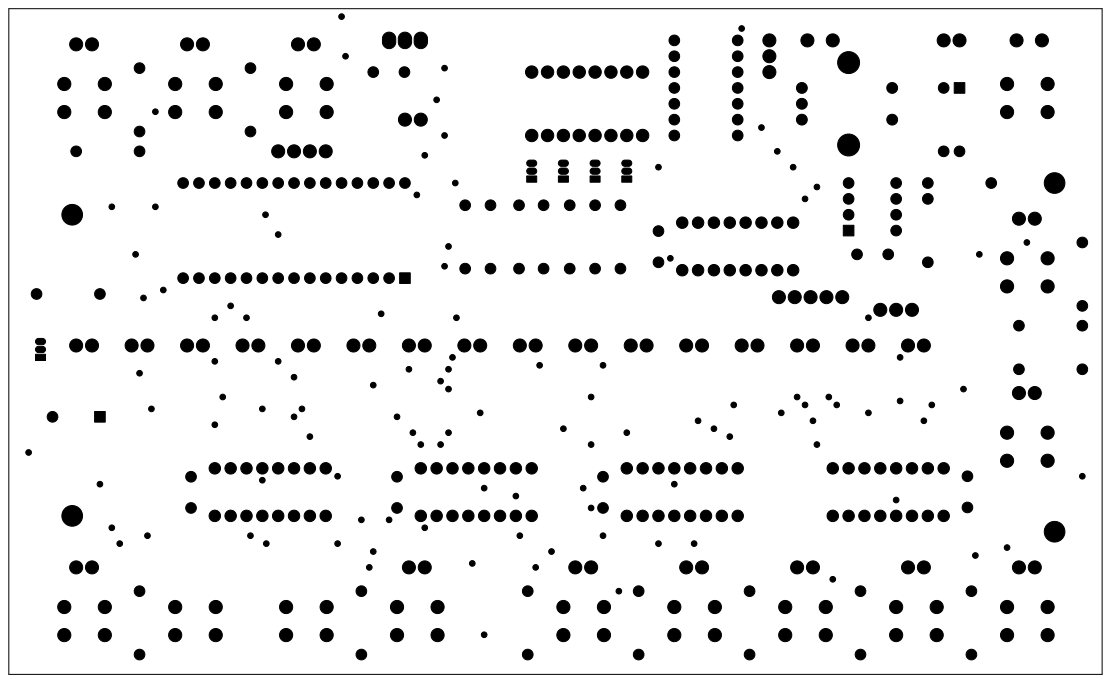
[picture p35: page 1]
