pfeuh/yass/doc/electronicCao/docs/YASS_v3-B_SilkS.pdf

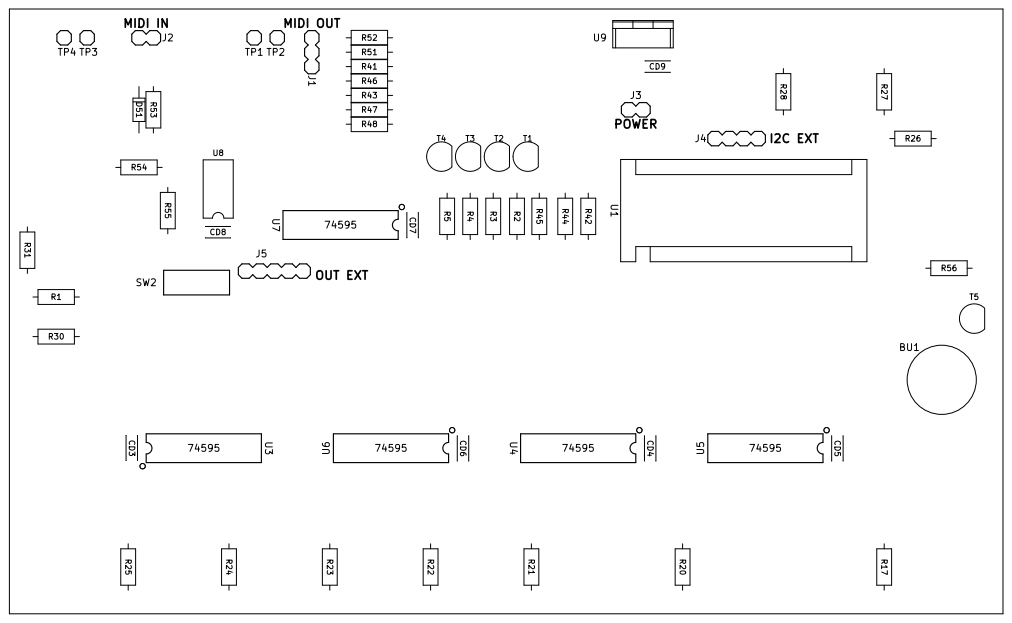
[picture p36: page 1]
