pfeuh/yass/doc/electronicCao/docs/YASS_v3-F_Cu.pdf

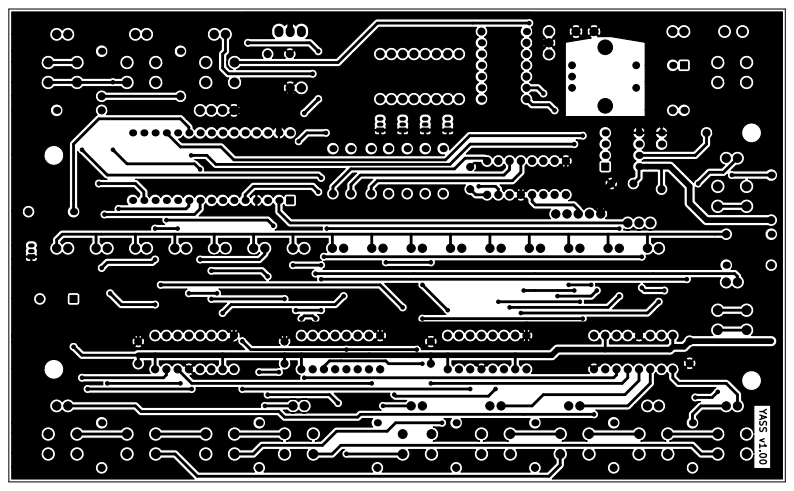
[picture p37: page 1]
