pfeuh/yass/doc/electronicCao/docs/YASS_v3-F_SilkS.pdf

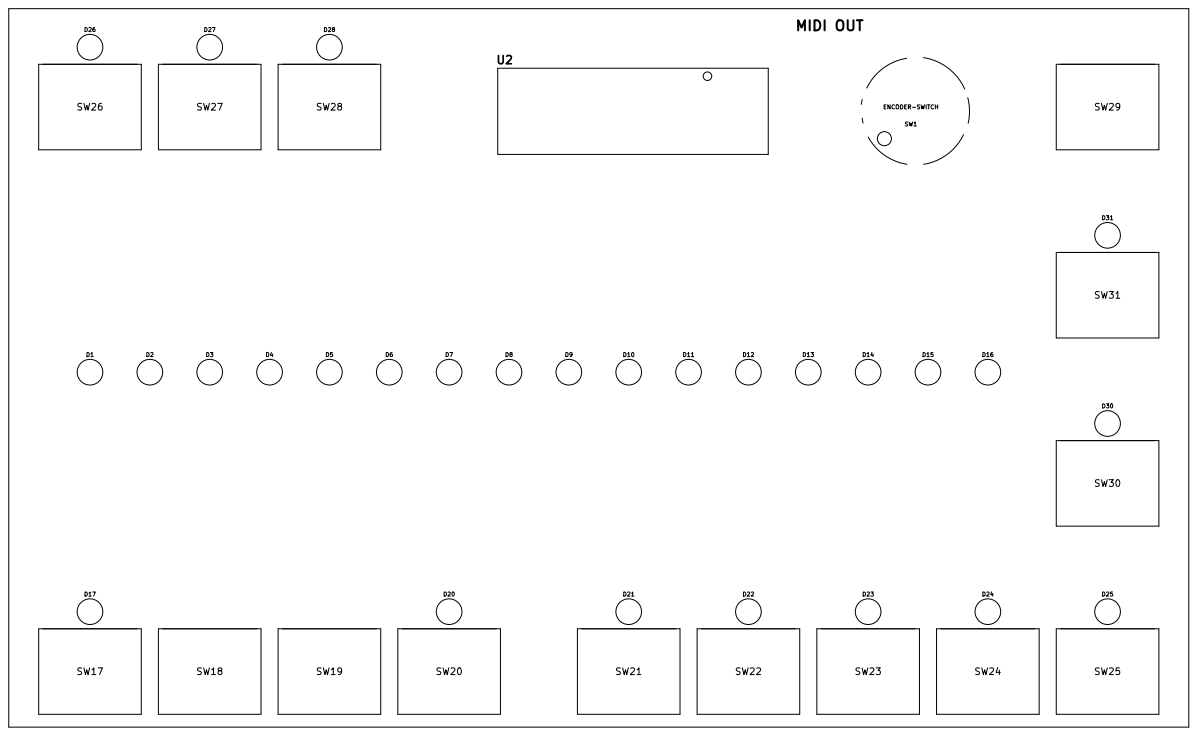
[picture p38: page 1]
