pfeuh/yass/doc/electronicCao/docs/yassFaceAvant.pdf

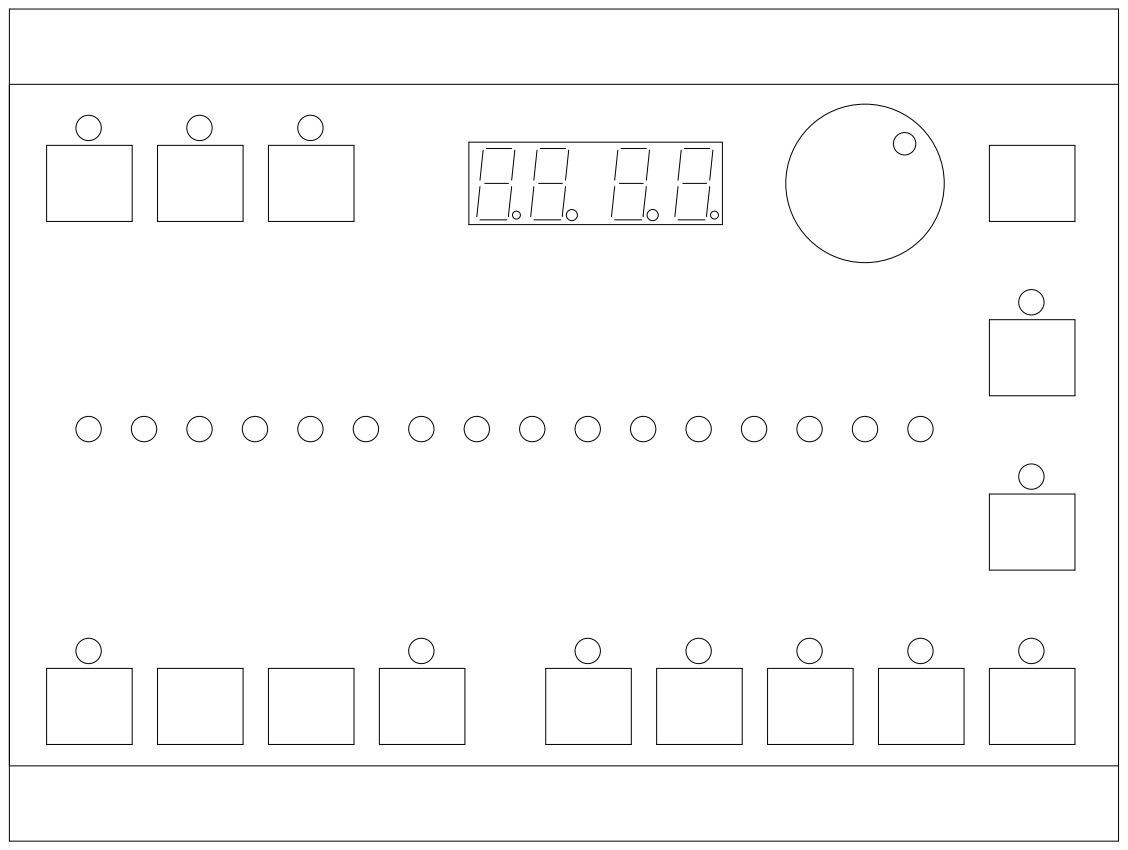
[picture p39: page 1]
