pfeuh/yass/doc/electronicCao/YASS_v2.kicad_pcb

## KiCad design doc/electronicCao/YASS_v2.kicad_pcb (2019-09-05)

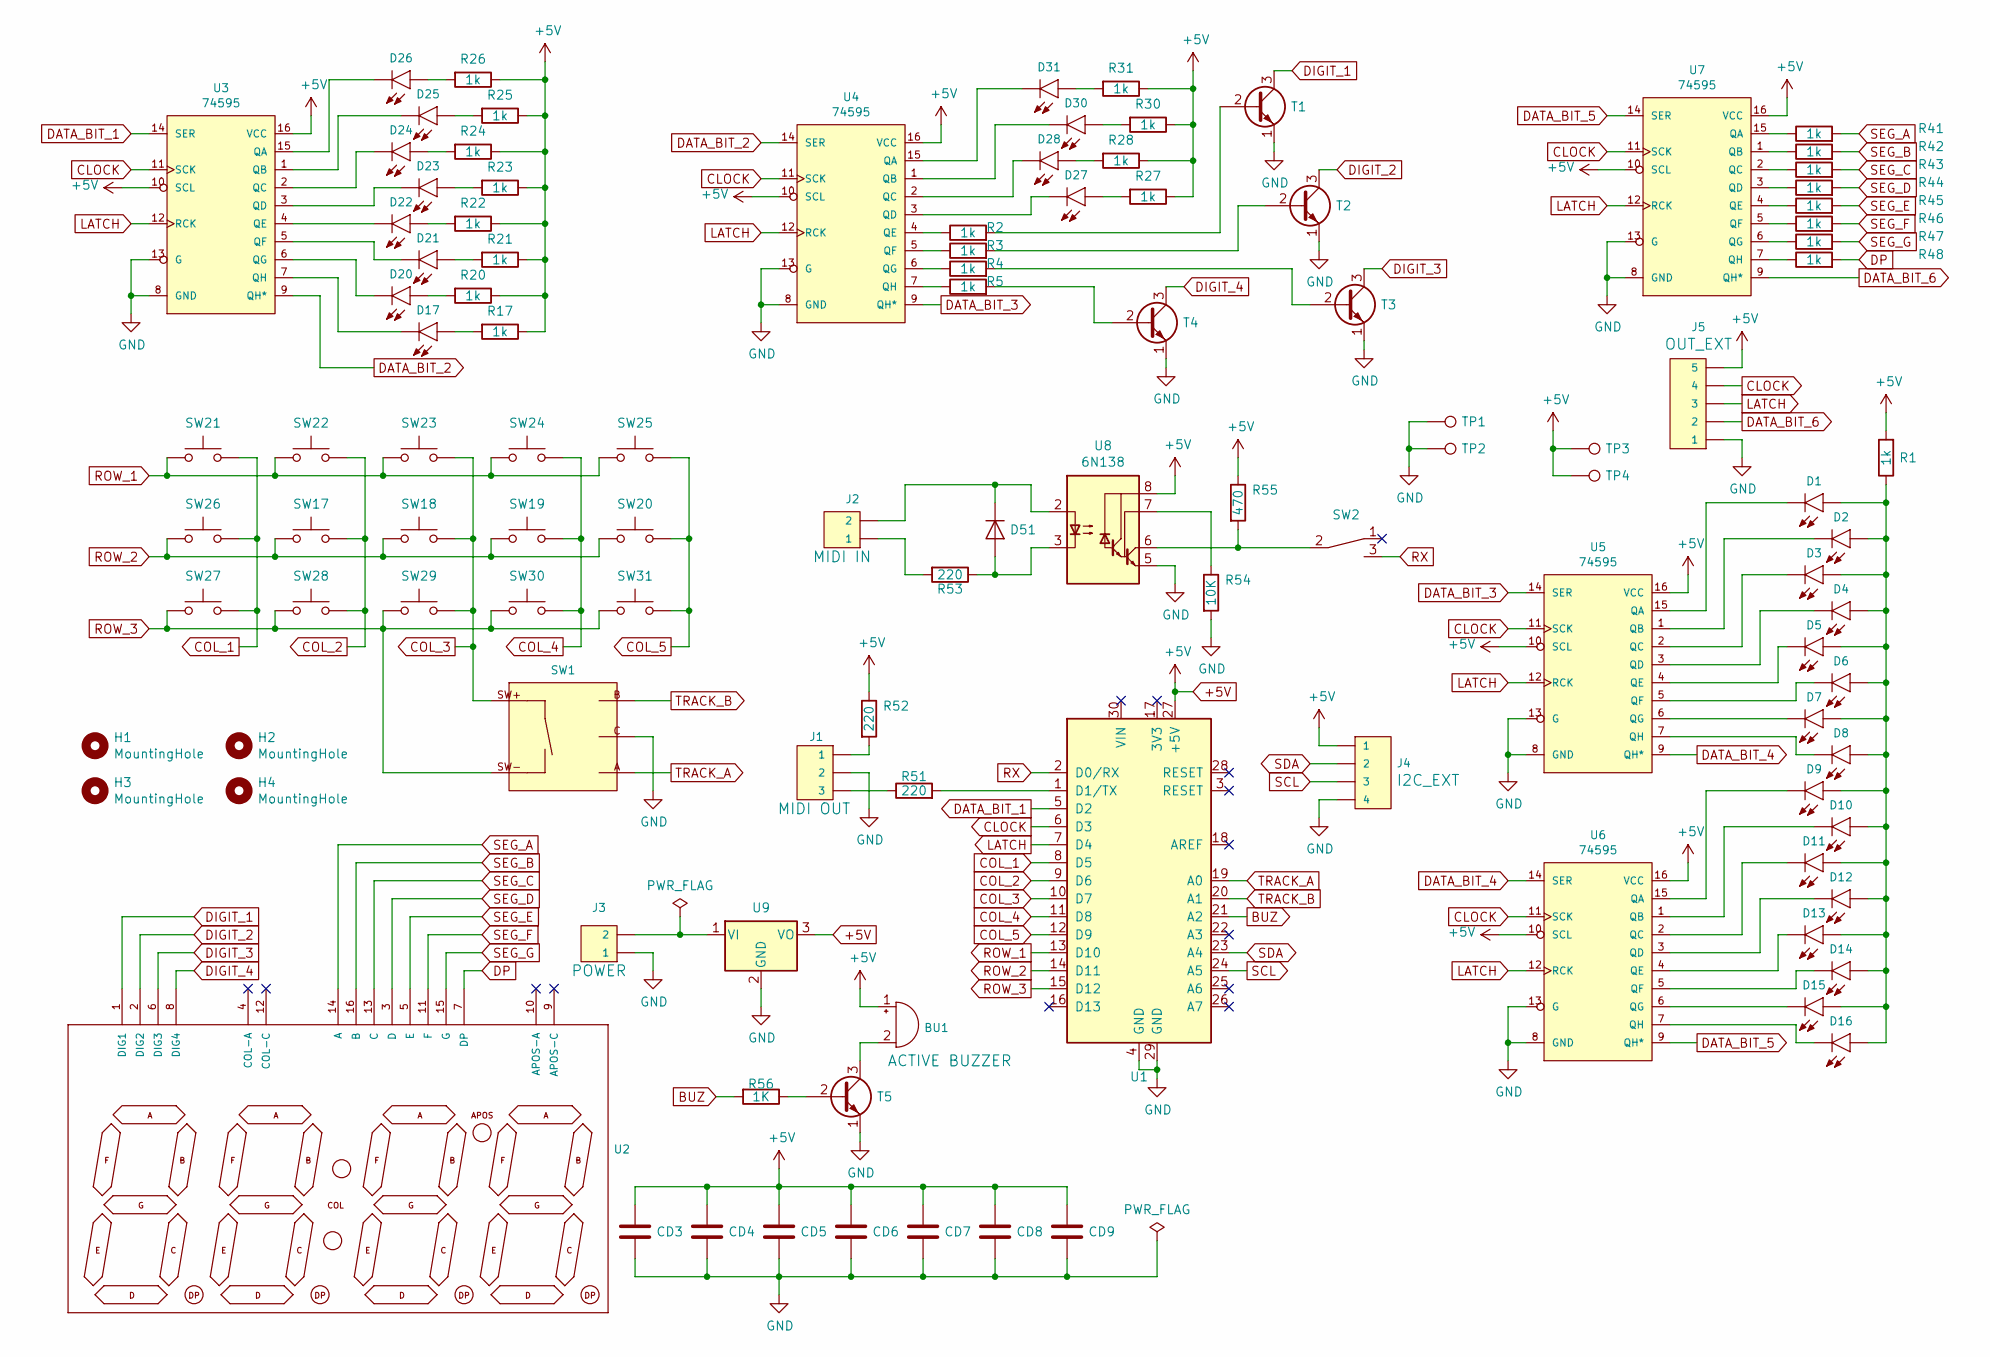
[picture p40: schematic YASS_v2.sch]

Parts:
BU1: BUZZER-PTH_KIT_NO_SILK; MagneticBuzzer_ProSignal_ABI-009-RC
CD3, CD4, CD5, CD6, CD7, CD8, CD9: 100nF; C_Disc_D4.3mm_W1.9mm_P5.00mm
D1, D2, D3, D4, D5, D6, D7, D8, D9, D10, D11, D12, D13, D14, D15, D16, D20: 3mm red; LED_3MM
D17: 3mm green; LED_3MM
D21, D22, D23, D24, D25: 3mm blue; LED_3MM
D26, D27, D28, D30, D31: 3mm yellow; LED_3MM
D51: 1N4148; DIODE
H1, H2, H3, H4: MountingHole; MountingHole_3.2mm_M3
J1: CONN_03; 1X03
J2: CONN_02; 1X02
J3: POWER CONNECTOR; 1X02
J4: CONN_04; 1X04
J5: CONN_05; 1X05
R1, R2, R3, R4, R5, R17, R20, R21, R22, R23, R24, R25, R26, R27, R28, R30, R31, R41, R42, R43, R44, R45, R46, R47, R48: 1k; R
R51, R52, R53: 220; R
R54: 10K; R
R55: 470; R
R56: 1K; R_Axial_DIN0207_L6.3mm_D2.5mm_P10.16mm_Horizontal
SW1: ENCODER-SWITCH; ROTARY_ENCODER
SW2: SWITCH_TOGGLE_SPST_RIGHT_ANGLE; SWITCH_SPDT_PTH_11.6X4.0MM
SW17, SW18, SW19, SW20, SW21, SW22, SW23, SW24, SW25, SW26, SW27, SW28, SW29, SW30, SW31: SW_Push; KEY_PUSH_6mm
T1, T3, T4, T5: 2N2222; TO-92_Inline_Narrow_Oval
T2: PN2222A; TO-92_Inline_Narrow_Oval
TP1, TP2, TP3, TP4: TestPoint; 1X01
U1: Arduino_Nano_v2.x; Arduino_Nano
U2: 7-SEGMENT-4DIGIT-10MM-RED; 4x7segments
U3, U4, U5, U6, U7: 74595; DIP16
U8: 6N138; DIP-8_W7.62mm
U9: LM7805_TO220; TO-220

Connections:
+5V: BU1.1 (-), CD3.1, CD4.1, CD5.1, CD6.1, CD7.1, CD8.1, CD9.1, J4.1, J5.5, R1.2, R17.1, R20.1, R21.1, R22.1, R23.1, R24.1, R25.1, R26.1, R27.1, R28.1, R30.1, R31.1, R52.1, R55.1, TP3.1, TP4.1, U1.27 (+5V), U3.10 (SCL), U3.16 (VCC), U4.10 (SCL), U4.16 (VCC), U5.10 (SCL), U5.16 (VCC), U6.10 (SCL), U6.16 (VCC), U7.10 (SCL), U7.16 (VCC), U8.8 (VCC), U9.3 (VO)
BUZ: R56.2, U1.21 (A2)
CLOCK: J5.4, U1.6 (D3), U3.11 (SCK), U4.11 (SCK), U5.11 (SCK), U6.11 (SCK), U7.11 (SCK)
COL_1: SW21.2, SW26.2, SW27.2, U1.8 (D5)
COL_2: SW17.2, SW22.2, SW28.2, U1.9 (D6)
COL_3: SW1.SW+, SW18.2, SW23.2, SW29.2, U1.10 (D7)
COL_4: SW19.2, SW24.2, SW30.2, U1.11 (D8)
COL_5: SW20.2, SW25.2, SW31.2, U1.12 (D9)
DATA_BIT_1: U1.5 (D2), U3.14 (SER)
DATA_BIT_2: U3.9 (QH*), U4.14 (SER)
DATA_BIT_3: U4.9 (QH*), U5.14 (SER)
DATA_BIT_4: U5.9 (QH*), U6.14 (SER)
DATA_BIT_5: U6.9 (QH*), U7.14 (SER)
DATA_BIT_6: J5.2, U7.9 (QH*)
DIGIT_1: T1.3 (C), U2.1 (DIG1)
DIGIT_2: T2.3 (C), U2.2 (DIG2)
DIGIT_3: T3.3 (C), U2.6 (DIG3)
DIGIT_4: T4.3 (C), U2.8 (DIG4)
DP: R48.2, U2.7 (DP)
GND: CD3.2, CD4.2, CD5.2, CD6.2, CD7.2, CD8.2, CD9.2, J1.2, J3.1, J4.4, J5.1, R54.2, SW1.C, T1.1 (E), T2.1 (E), T3.1 (E), T4.1 (E), T5.1 (E), TP1.1, TP2.1, U1.4 (GND), U1.29 (GND), U3.8 (GND), U3.13 (G), U4.8 (GND), U4.13 (G), U5.8 (GND), U5.13 (G), U6.8 (GND), U6.13 (G), U7.8 (GND), U7.13 (G), U8.5 (GND), U9.2 (GND)
LATCH: J5.3, U1.7 (D4), U3.12 (RCK), U4.12 (RCK), U5.12 (RCK), U6.12 (RCK), U7.12 (RCK)
unnamed: BU1.2 (+), T5.3 (C)
unnamed: D1.A, D2.A, D3.A, D4.A, D5.A, D6.A, D7.A, D8.A, D9.A, D10.A, D11.A, D12.A, D13.A, D14.A, D15.A, D16.A, R1.1
unnamed: D1.K (C), U5.15 (QA)
unnamed: D2.K (C), U5.1 (QB)
unnamed: D3.K (C), U5.2 (QC)
unnamed: D4.K (C), U5.3 (QD)
unnamed: D5.K (C), U5.4 (QE)
unnamed: D6.K (C), U5.5 (QF)
unnamed: D7.K (C), U5.6 (QG)
unnamed: D8.K (C), U5.7 (QH)
unnamed: D9.K (C), U6.15 (QA)
unnamed: D10.K (C), U6.1 (QB)
unnamed: D11.K (C), U6.2 (QC)
unnamed: D12.K (C), U6.3 (QD)
unnamed: D13.K (C), U6.4 (QE)
unnamed: D14.K (C), U6.5 (QF)
unnamed: D15.K (C), U6.6 (QG)
unnamed: D16.K (C), U6.7 (QH)
unnamed: D17.A, R17.2
unnamed: D17.K (C), U3.7 (QH)
unnamed: D20.A, R20.2
unnamed: D20.K (C), U3.6 (QG)
unnamed: D21.A, R21.2
unnamed: D21.K (C), U3.5 (QF)
unnamed: D22.A, R22.2
unnamed: D22.K (C), U3.4 (QE)
unnamed: D23.A, R23.2
unnamed: D23.K (C), U3.3 (QD)
unnamed: D24.A, R24.2
unnamed: D24.K (C), U3.2 (QC)
unnamed: D25.A, R25.2
unnamed: D25.K (C), U3.1 (QB)
unnamed: D26.A, R26.2
unnamed: D26.K (C), U3.15 (QA)
unnamed: D27.A, R27.2
unnamed: D27.K (C), U4.3 (QD)
unnamed: D28.A, R28.2
unnamed: D28.K (C), U4.2 (QC)
unnamed: D30.A, R30.2
unnamed: D30.K (C), U4.1 (QB)
unnamed: D31.A, R31.2
unnamed: D31.K (C), U4.15 (QA)
unnamed: D51.1 (K), J2.2, U8.2 (C1)
unnamed: D51.2 (A), R53.1, U8.3 (C2)
unnamed: J1.1, R52.2
unnamed: J1.3, R51.1
unnamed: J2.1, R53.2
unnamed: J3.2, U9.1 (VI)
unnamed: R2.1, U4.4 (QE)
unnamed: R2.2, T1.2 (B)
unnamed: R3.1, U4.5 (QF)
unnamed: R3.2, T2.2 (B)
unnamed: R4.1, U4.6 (QG)
unnamed: R4.2, T3.2 (B)
unnamed: R5.1, U4.7 (QH)
unnamed: R5.2, T4.2 (B)
unnamed: R41.1, U7.15 (QA)
unnamed: R42.1, U7.1 (QB)
unnamed: R43.1, U7.2 (QC)
unnamed: R44.1, U7.3 (QD)
unnamed: R45.1, U7.4 (QE)
unnamed: R46.1, U7.5 (QF)
unnamed: R47.1, U7.6 (QG)
unnamed: R48.1, U7.7 (QH)
unnamed: R51.2, U1.1 (D1/TX)
unnamed: R54.1, U8.7 (VO1)
unnamed: R55.2, SW2.2, U8.6 (VO2)
unnamed: R56.1, T5.2 (B)
ROW_1: SW21.1, SW22.1, SW23.1, SW24.1, SW25.1, U1.13 (D10)
ROW_2: SW17.1, SW18.1, SW19.1, SW20.1, SW26.1, U1.14 (D11)
ROW_3: SW1.SW-, SW27.1, SW28.1, SW29.1, SW30.1, SW31.1, U1.15 (D12)
RX: SW2.3, U1.2 (D0/RX)
SCL: J4.3, U1.24 (A5)
SDA: J4.2, U1.23 (A4)
SEG_A: R41.2, U2.14 (A)
SEG_B: R42.2, U2.16 (B)
SEG_C: R43.2, U2.13 (C)
SEG_D: R44.2, U2.3 (D)
SEG_E: R45.2, U2.5 (E)
SEG_F: R46.2, U2.11 (F)
SEG_G: R47.2, U2.15 (G)
TRACK_A: SW1.A, U1.19 (A0)
TRACK_B: SW1.B, U1.20 (A1)

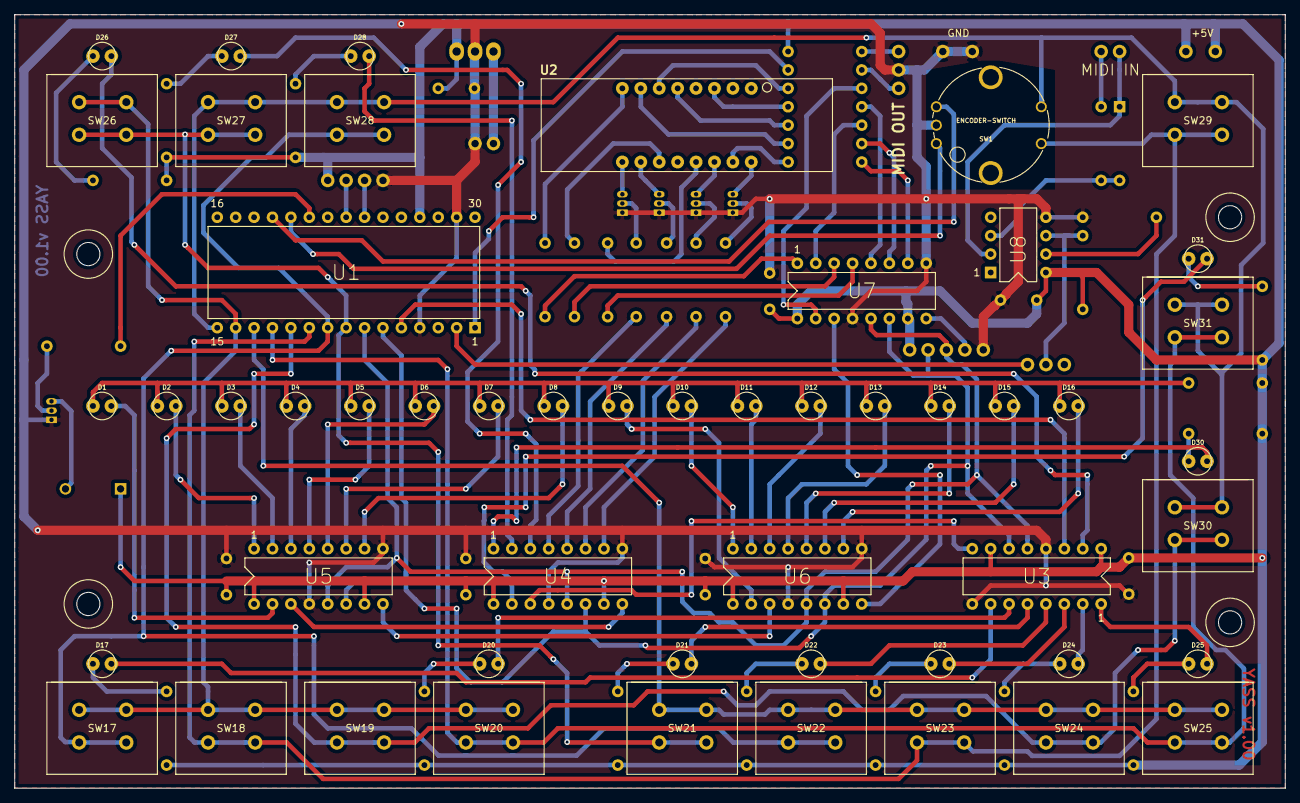
[picture p41: board YASS_v2.kicad_pcb from above]

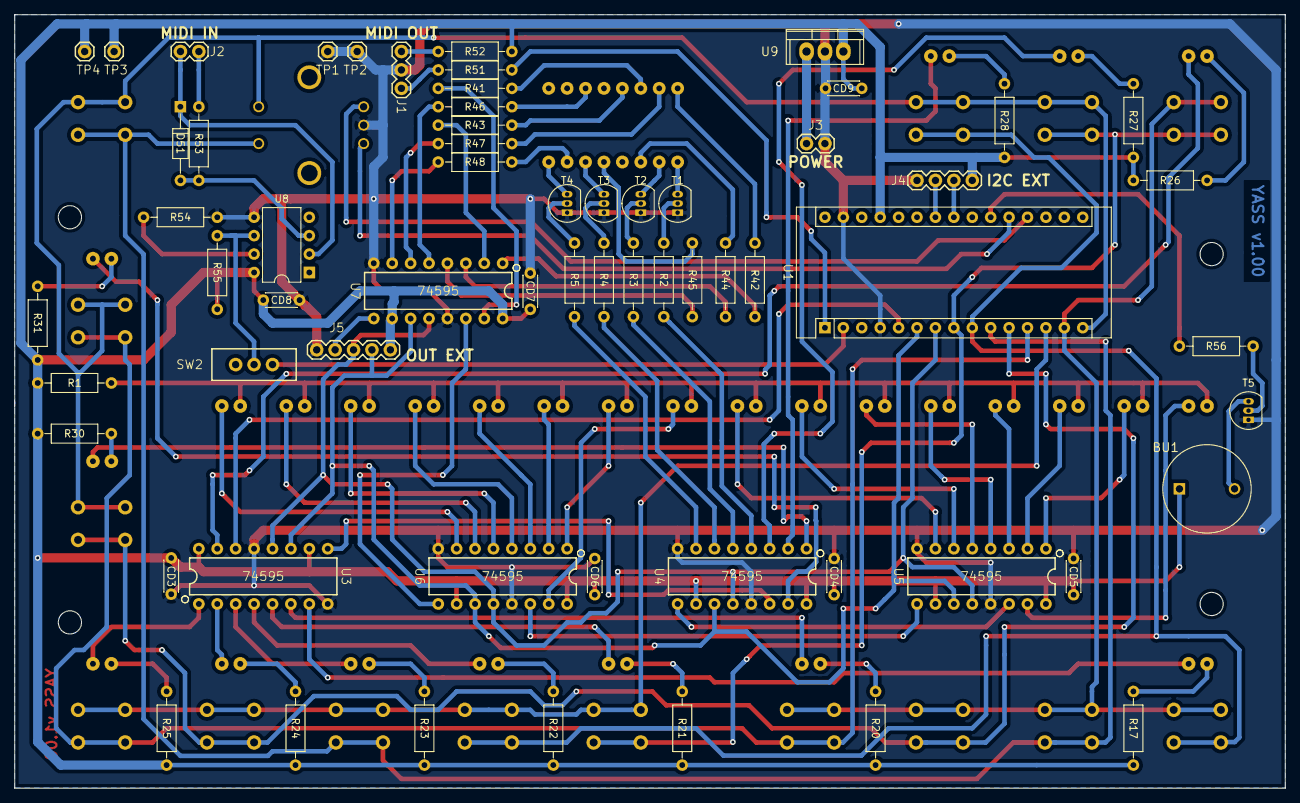
[picture p42: board YASS_v2.kicad_pcb from below]

Board: 2 copper layers, 175.3 x 106.7 mm, 112 parts (63 on the bottom side), 104 nets.
