pfeuh/yass/yassMaintenance.cpp

/*
 * file : yassMaintenance.cpp
 * Copyright (c) pfeuh <ze.pfeuh@gmail>
 * All rights reserved.
 * 
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
 * You should have received a copy of the GNU General Public License
 * along with this program.  If not, see <http://www.gnu.org/licenses/>.
 */

#include <EEPROM.h>
#include "yassMaintenance.h"

#define YASS_MAINTENANCE_STATE_READY       1
#define YASS_MAINTENANCE_STATE_STEP_LEDS   2
#define YASS_MAINTENANCE_STATE_INDV_LEDS   3
#define YASS_MAINTENANCE_STATE_DISPLAY     4
#define YASS_MAINTENANCE_STATE_KEYBOARD    5
#define YASS_MAINTENANCE_STATE_BEEPER      6
#define YASS_MAINTENANCE_STATE_ENCODER     7
#define YASS_MAINTENANCE_STATE_EEPROM      8
#define YASS_MAINTENANCE_STATE_INPUT_ADDR  9
#define YASS_MAINTENANCE_STATE_INPUT_VALUE 10

#define ledNum gpv1
#define ledDirection gpv2
#define YASS_MAINTENANCE_LED_MSEC_DURATION 150

#define segmentWeight gpv1
#define digitNum gpv2
#define YASS_MAINTENANCE_DISPLAY_MSEC_DURATION 300

#define YASS_MAINTENANCE_ENCODER_MSEC_DURATION 1000

const byte sortedLeds[] PROGMEM =
{
    LED_START,
    LED_RECORD,
    LED_1,
    LED_2,
    LED_3,
    LED_4,
    LED_5,
    LED_SEQUENCE,
    LED_GLOBAL,
    LED_MULTI_USAGE,
    LED_TIE,
    LED_REST
};

const bool beeperTestStates[] PROGMEM = {1, 0, 1, 0, 1, 1, 0, 1, 1, 0, 1, 0, 1, 0, 0, 0};
#define YASS_MAINTENANCE_NB_BEEPER_TEST_STATES (sizeof(beeperTestStates) / sizeof(bool))
#define YASS_MAINTENANCE_BEEPER_MSEC_DURATION 150
#define beeperIndex gpv1

const char msgKey[] PROGMEM = "key ";
const char msgPressed[] PROGMEM = " pressed.\n";

const char YASS_MAINTENANCE_kbd_1[] PROGMEM = "SEQ1";
const char YASS_MAINTENANCE_kbd_2[] PROGMEM = "SEQ2";
const char YASS_MAINTENANCE_kbd_3[] PROGMEM = "SEQ3";
const char YASS_MAINTENANCE_kbd_4[] PROGMEM = "SEQ4";
const char YASS_MAINTENANCE_kbd_5[] PROGMEM = "SEQ5";
const char YASS_MAINTENANCE_kbd_next[] PROGMEM = "NEXT";
const char YASS_MAINTENANCE_kbd_start[] PROGMEM = "PLAY";
const char YASS_MAINTENANCE_kbd_pause[] PROGMEM = "STOP";
const char YASS_MAINTENANCE_kbd_previous[] PROGMEM = "PREV.";
const char YASS_MAINTENANCE_kbd_record[] PROGMEM = "REC.";
const char YASS_MAINTENANCE_kbd_global[] PROGMEM = "GLOB.";
const char YASS_MAINTENANCE_kbd_sequence[] PROGMEM = "SEQ.";
const char YASS_MAINTENANCE_kbd_rest[] PROGMEM = "REST";
const char YASS_MAINTENANCE_kbd_tie[] PROGMEM = "TIE";
const char YASS_MAINTENANCE_kbd_multi_usage[] PROGMEM = "DATA";

int YASS_MAINTENANCE_encoderData;

void YASS_MAINTENANCE_updateData(bool direction)
{
    if(direction)
        YASS_MAINTENANCE_encoderData++;
    else
        YASS_MAINTENANCE_encoderData--;
}

/*******************/
/* Private methods */
/*******************/

void YASS_MAINTENANCE::romPrint(const char* addr)
{
    while(pgm_read_byte(addr))
        console.write(pgm_read_byte(addr++));
}

void YASS_MAINTENANCE::setState(byte _state)
{
    state = _state;
    resetOutputs();
    gpv1 = 0;
    gpv2 = 0;
    milestone = millis();
}

bool inline YASS_MAINTENANCE::itsTime()
{
    return millis() >= milestone;
}

void YASS_MAINTENANCE::displayVersions()
{
    console.println(F("Yass             " YASS_VERSION));
    console.println(F("Sequencer        " YASS_SEQUENCER_VERSION));
    console.println(F("Sequences        " YASS_SEQUENCE_VERSION));
    console.println(F("Global config.   " YASS_CONFIG_VERSION));
    console.println(F("Keyboard         " YASS_KEYB_VERSION));
    console.println(F("Beeper           " YASS_BEEPER_VERSION));
    console.println(F("Monostable       " YASS_MONOSTABLE_VERSION));
    console.println(F("GP outputs       " YASS_GPO_VERSION));
    console.println(F("Leds driver      " YASS_LEDS_VERSION));
    console.println(F("Display driver   " YASS_DISPLAY_VERSION));
    console.println(F("Ticks generator  " YASS_TICKS_VERSION));
    console.println(F("ROM seqs         " YASS_ROM_SEQUENCES_VERSION));
    console.println(F("sysEx driver     " YASS_SYS_EX_VERSION));
    console.println(F("Eeprom driver    " YASS_EEPROM_VERSION));
    console.println(F("Tempo calculator " YASS_COMPUTE_BEAT_VERSION));
    console.println(F("Arduino debug    " ARDUINO_DEBUG_VERSION "\n"));
}

void YASS_MAINTENANCE::prompt()
{
    console.println(F("\n? invoke this menu"));
    console.println(F("1 test step leds"));
    console.println(F("2 test individual leds"));
    console.println(F("3 test display"));
    console.println(F("4 test keyboard"));
    console.println(F("5 test beeper"));
    console.println(F("6 test encoder"));
    console.println(F("r read eeprom"));
    console.println(F("w write eeprom"));
    console.println(F("s stop any test"));
    console.println(F("v display versions"));
}

void YASS_MAINTENANCE::resetOutputs()
{
    display->clear();
    display->writeDot(0, 0);
    display->writeDot(0, 1);
    display->writeDot(0, 2);
    display->writeDot(0, 3);
    leds->clearLeds();
}

void YASS_MAINTENANCE::stateStepLeds()
{
    if(itsTime())
    {
        milestone += YASS_MAINTENANCE_LED_MSEC_DURATION;
        leds->clearLeds();
        leds->stepLedOn(ledNum);
        if(ledDirection == 0)
        {
            ledNum++;
            if(ledNum == YASS_LEDS_NB_STEP_LEDS)
            {
                ledNum -= 2;
                ledDirection = 1;
            }
        }
        else
        {
            ledNum--;
            if(ledNum == 255)
            {
                ledNum += 2;
                ledDirection = 0;
            }
        }
    }
}

void YASS_MAINTENANCE::stateIndividualLeds()
{
    if(itsTime())
    {
        milestone += YASS_MAINTENANCE_LED_MSEC_DURATION;
        leds->clearLeds();
        leds->ledOn(pgm_read_byte(sortedLeds + ledNum));
        if(ledDirection == 0)
        {
            ledNum++;
            if(ledNum == YASS_LEDS_NB_INDIVIDUAL_LEDS)
            {
                ledNum -= 2;
                ledDirection = 1;
            }
        }
        else
        {
            ledNum--;
            if(ledNum == 255)
            {
                ledNum += 2;
                ledDirection = 0;
            }
        }
    }
}

void YASS_MAINTENANCE::stateDisplay()
{
    if(itsTime())
    {
        milestone += YASS_MAINTENANCE_DISPLAY_MSEC_DURATION;
        byte* digit_ptr = display->getDigitsPtr();
        //~ display->clear();
        resetOutputs();
        *(digit_ptr + digitNum) = segmentWeight;
        digitNum += 1;
        if(digitNum == display->getNbDigits())
        {
            digitNum = 0;
            segmentWeight <<= 1;
            if(!segmentWeight)
                segmentWeight = 1;
            }
        }
}

void YASS_MAINTENANCE::stateBeeper()
{
    if(itsTime())
    {
        milestone += YASS_MAINTENANCE_BEEPER_MSEC_DURATION;
        if(pgm_read_byte(beeperTestStates + beeperIndex))
            beeper->beep();
        beeperIndex += 1;
        if(beeperIndex == YASS_MAINTENANCE_NB_BEEPER_TEST_STATES)
            beeperIndex = 0;
    }
}

void YASS_MAINTENANCE::keyMessage(const char* msg)
{
    romPrint(msgKey);
    romPrint(msg);
    romPrint(msgPressed);
}

void YASS_MAINTENANCE::stateKeyboard()
{
    if(keyb->available())
        switch(keyb->read())
        {
            case KBD_1:
                keyMessage(YASS_MAINTENANCE_kbd_1);
                break;
            case KBD_2:
                keyMessage(YASS_MAINTENANCE_kbd_2);
                break;
            case KBD_3:
                keyMessage(YASS_MAINTENANCE_kbd_3);
                break;
            case KBD_4:
                keyMessage(YASS_MAINTENANCE_kbd_4);
                break;
            case KBD_5:
                keyMessage(YASS_MAINTENANCE_kbd_5);
                break;
            case KBD_NEXT:
                keyMessage(YASS_MAINTENANCE_kbd_next);
                break;
            case KBD_START:
                keyMessage(YASS_MAINTENANCE_kbd_start);
                break;
            case KBD_PAUSE:
                keyMessage(YASS_MAINTENANCE_kbd_pause);
                break;
            case KBD_PREVIOUS:
                keyMessage(YASS_MAINTENANCE_kbd_previous);
                break;
            case KBD_RECORD:
                keyMessage(YASS_MAINTENANCE_kbd_record);
                break;
            case KBD_GLOBAL:
                keyMessage(YASS_MAINTENANCE_kbd_global);
                break;
            case KBD_SEQUENCE:
                keyMessage(YASS_MAINTENANCE_kbd_sequence);
                break;
            case KBD_REST:
                keyMessage(YASS_MAINTENANCE_kbd_rest);
                break;
            case KBD_TIE:
                keyMessage(YASS_MAINTENANCE_kbd_tie);
                break;
            case KBD_MULTI_USAGE:
                keyMessage(YASS_MAINTENANCE_kbd_multi_usage);
                break;
            default:
                break;
        }
}

void YASS_MAINTENANCE::stateEncoder()
{
    if(itsTime())
    {
        milestone += YASS_MAINTENANCE_ENCODER_MSEC_DURATION;
        console.println(YASS_MAINTENANCE_encoderData);
    }
}

void YASS_MAINTENANCE::stateEeprom()
{
    // displaying eepromed configuration
    console.println(F("Global configuration"));
    debug->dumpEeprom(YASS_EEPROM_BASE_GLOBAL, YASS_CONFIG_DATA_SIZE);
    
    // displaying eepromed sequences
    word ptr = YASS_EEPROM_BASE_SEQ1;
    for(byte x = 0; x < NB_SEQS; x++)
    {
        console.print(F("Sequence "));
        console.println(x+1);
        debug->dumpEeprom(ptr, YASS_SEQUENCE_DATA_SIZE);
        ptr += YASS_SEQUENCE_DATA_SIZE;
    }
    state = YASS_MAINTENANCE_STATE_READY;
    
    // checking and reporting bad midi data
    byte value;
    word count = 0;
    console.write('\n');
    
    for(word addr = YASS_EEPROM_BASE_GLOBAL; addr < YASS_EEPROM_BASE_FREE; addr++)
    {
        value = ARDUINO_DEBUG_getEepromByte(addr);
        if(value & 0x80)
        {
            count++;
            debug->printWord(addr);
            console.write(' ');
            debug->printByte(value);
            console.write('\n');
        }
    }
    if(count)
    {
        console.print(value);
        console.println(F(" unexpected 8 bits value(s) found!"));
    }
}

/******************/
/* Public methods */
/******************/

YASS_MAINTENANCE::YASS_MAINTENANCE()
{
}

void YASS_MAINTENANCE::begin(
        YASS_EDIT_FSM* _editor,
        YASS_KEYB* _keyb,
        YASS_BEEPER* _beeper,
        YASS_CONFIG* glob_conf,
        YASS_SEQUENCER* _player,
        YASS_DISPLAY* _display,
        YASS_LEDS* _leds,
        ARDUINO_DEBUG* _debug)
{
    keyb = _keyb;
    beeper = _beeper;
    globConf = glob_conf;
    player = _player;
    display = _display;
    leds = _leds,
    debug = _debug;
    
    console.flush();
    console.begin(9600);
    _editor->getEncoder()->bind(YASS_MAINTENANCE_updateData);
    resetOutputs();
    console.println(F("---*** YASS MAINTENANCE ***---\n"));
    prompt();
    
}

void YASS_MAINTENANCE::sequencer()
{
    if((state == YASS_MAINTENANCE_STATE_INPUT_ADDR) || (state == YASS_MAINTENANCE_STATE_INPUT_VALUE))
    {
        if(console.available())
        {
            char car = console.read();
            switch (car)
            {
                case '0':
                case '1':
                case '2':
                case '3':
                case '4':
                case '5':
                case '6':
                case '7':
                case '8':
                case '9':
                    userValue = (userValue << 4) + car - '0';
                    break;
                case 'a':
                case 'b':
                case 'c':
                case 'd':
                case 'e':
                case 'f':
                    userValue = (userValue << 4) + car - 'a' + 10;
                    break;
                case '\n':
                    if(state == YASS_MAINTENANCE_STATE_INPUT_ADDR)
                    {
                        eepromAddr = userValue;
                        debug->printWord(eepromAddr);
                        userValue = 0;
                        setState(YASS_MAINTENANCE_STATE_INPUT_VALUE);
                    }
                    else if(state == YASS_MAINTENANCE_STATE_INPUT_VALUE)
                    {
                        eepromValue = userValue;
                        EEPROM.update(eepromAddr, eepromValue);
                        console.print(F(" <- "));
                        debug->printByte(EEPROM.read(eepromAddr));
                        console.write('\n');
                        userValue = 0;
                        setState(YASS_MAINTENANCE_STATE_READY);
                    }
                    break;
                case 's':
                    console.println(F("aborted by user!"));
                    setState(YASS_MAINTENANCE_STATE_READY);
                    break;
                default:
                    break;
            }
        }
    }
    else
    {
        if(console.available())
        {
            switch (console.read())
            {
                case '?':
                    setState(YASS_MAINTENANCE_STATE_READY);
                    prompt();
                    break;
                case '1':
                    setState(YASS_MAINTENANCE_STATE_STEP_LEDS);
                    console.println(F("\nTesting step leds."));
                    break;
                case '2':
                    setState(YASS_MAINTENANCE_STATE_INDV_LEDS);
                    console.println(F("\nTesting individual leds."));
                    break;
                case '3':
                    setState(YASS_MAINTENANCE_STATE_DISPLAY);
                    segmentWeight = 1;
                    console.println(F("\nTesting display's segments."));
                    break;
                case '4':
                    setState(YASS_MAINTENANCE_STATE_KEYBOARD);
                    console.println(F("\nTesting keyboard. Hit keys"));
                    break;
                case '5':
                    setState(YASS_MAINTENANCE_STATE_BEEPER);
                    console.println(F("\nTesting beeper."));
                    break;
                case '6':
                    setState(YASS_MAINTENANCE_STATE_ENCODER);
                    console.println(F("\nTesting encoder. Change value manually."));
                    break;
                case 'r':
                    setState(YASS_MAINTENANCE_STATE_EEPROM);
                    console.println(F("\nDumping eeprom."));
                    break;
                case 'v':
                    displayVersions();
                    break;
                case 'w':
                    // ugly turnaround to remove the '\n' from "w\n" input
                    delay(2);
                    console.read();
                
                    userValue = 0;
                    console.println(F("Input eeprom hex address, then hex value or 's' to stop"));
                    setState(YASS_MAINTENANCE_STATE_INPUT_ADDR);
                    break;
                case 's':
                    console.println(F("\nTest stopped."));
                    setState(YASS_MAINTENANCE_STATE_READY);
                    break;
                default:
                    break;
            }
        }
    }
    switch (state)
    {
        case YASS_MAINTENANCE_STATE_STEP_LEDS:
            stateStepLeds();
            break;
        case YASS_MAINTENANCE_STATE_INDV_LEDS:
            stateIndividualLeds();
            break;
        case YASS_MAINTENANCE_STATE_DISPLAY:
            stateDisplay();
            break;
        case YASS_MAINTENANCE_STATE_KEYBOARD:
            stateKeyboard();
            break;
        case YASS_MAINTENANCE_STATE_BEEPER:
            stateBeeper();
            break;
        case YASS_MAINTENANCE_STATE_ENCODER:
            stateEncoder();
            break;
        case YASS_MAINTENANCE_STATE_EEPROM:
            stateEeprom();
            break;
        case YASS_MAINTENANCE_STATE_READY:
        default:
            break;
    }
}
