pfeuh/yass/yassTicks.cpp

/*
 * file : yassTicks.cpp
 * Copyright (c) pfeuh <ze.pfeuh@gmail>
 * All rights reserved.
 * 
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
 * You should have received a copy of the GNU General Public License
 * along with this program.  If not, see <http://www.gnu.org/licenses/>.
 */

#include "yassTicks.h"

const PROGMEM word YASS_TICKS_usec_durations[] =
{
     45455, // 55 bpm
     44643, // 56 bpm
     43860, // 57 bpm
     43103, // 58 bpm
     42373, // 59 bpm
     41667, // 60 bpm
     40984, // 61 bpm
     40323, // 62 bpm
     39683, // 63 bpm
     39063, // 64 bpm
     38462, // 65 bpm
     37879, // 66 bpm
     37313, // 67 bpm
     36765, // 68 bpm
     36232, // 69 bpm
     35714, // 70 bpm
     35211, // 71 bpm
     34722, // 72 bpm
     34247, // 73 bpm
     33784, // 74 bpm
     33333, // 75 bpm
     32895, // 76 bpm
     32468, // 77 bpm
     32051, // 78 bpm
     31646, // 79 bpm
     31250, // 80 bpm
     30864, // 81 bpm
     30488, // 82 bpm
     30120, // 83 bpm
     29762, // 84 bpm
     29412, // 85 bpm
     29070, // 86 bpm
     28736, // 87 bpm
     28409, // 88 bpm
     28090, // 89 bpm
     27778, // 90 bpm
     27473, // 91 bpm
     27174, // 92 bpm
     26882, // 93 bpm
     26596, // 94 bpm
     26316, // 95 bpm
     26042, // 96 bpm
     25773, // 97 bpm
     25510, // 98 bpm
     25253, // 99 bpm
     25000, // 100 bpm
     24752, // 101 bpm
     24510, // 102 bpm
     24272, // 103 bpm
     24038, // 104 bpm
     23810, // 105 bpm
     23585, // 106 bpm
     23364, // 107 bpm
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
}

void YASS_TICKS::sequencer()
{
    if(runningFlag)
    {
        if(micros() >= milestone)
        {
            if(callback)
                callback();
            milestone += tickDuration;
        }
    }
}

byte* YASS_TICKS::getDataPointer()
{
    return (byte*)(&tempo);
}
