pfeuh/yass/yassSysEx.cpp

/*
 * file : yassSysEx.cpp
 * Copyright (c) pfeuh <ze.pfeuh@gmail>
 * All rights reserved.
 * 
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
 * You should have received a copy of the GNU General Public License
 * along with this program.  If not, see <http://www.gnu.org/licenses/>.
 */

#include "yassSysEx.h"

// TODO: this constant it everywere, should make it global
#define NB_SEQS 5

#define START_OF_SYS_EX 0xf0
#define END_OF_SYS_EX   0xf7

#define MANUFACTURER_BYTE_1 'y'
#define MANUFACTURER_BYTE_2 'a'
#define MANUFACTURER_BYTE_3 's'

#define STATE_READY   1
#define STATE_GLOBAL  2
#define STATE_SEQ_1   3
#define STATE_SEQ_2   4
#define STATE_SEQ_3   5
#define STATE_SEQ_4   6
#define STATE_SEQ_5   7

/*******************/
/* Private methods */
/*******************/

void YASS_SYS_EX::push(byte value)
{
    *(buffer + (bufferIndex++)) = value;
}

byte YASS_SYS_EX::pop()
{
    return *inputPtr++;
}

void YASS_SYS_EX::openSysExMessage()
{
    bufferIndex = 0;
    push(START_OF_SYS_EX);
    push(MANUFACTURER_BYTE_1);
    push(MANUFACTURER_BYTE_2);
    push(MANUFACTURER_BYTE_3);
}

void YASS_SYS_EX::closeAndSendSysExMessage()
{
    push(END_OF_SYS_EX);
    senderCallback(buffer, bufferIndex);
}

/******************/
/* Public methods */
/******************/

YASS_SYS_EX::YASS_SYS_EX()
{
}

void YASS_SYS_EX::begin(YASS_CONFIG* config_ptr, YASS_SEQUENCE* seqs_ptr)
{
        configPtr = config_ptr;
        seqsPtr = seqs_ptr;
        senderCallback = NULL;
        state = STATE_READY;
}

bool YASS_SYS_EX::isMessageForUs()
{
    // don't ask twice !!!
    pop(); // first byte is 0xf0, it has to be popped
    return (pop() == MANUFACTURER_BYTE_1) &&\
           (pop() == MANUFACTURER_BYTE_2) &&\
           (pop() == MANUFACTURER_BYTE_3);
}

void YASS_SYS_EX::executeSysEx(byte * array_ptr, word array_size)
{
    inputPtr = array_ptr;
    inputSize = array_size;
    
    if(isMessageForUs())
    {
        byte command = pop();
        switch(command)
        {
            case YASS_SYS_EX_ALL_DUMP_REQUEST:
                sendAll();
                break;
            case YASS_SYS_EX_GLOB_DUMP_REQUEST:
                sendGlobal();
                break;
            case YASS_SYS_EX_GLOB_DUMP:
                parseGlobal();
                break;
            case YASS_SYS_EX_SEQ_DUMP_REQUEST:
                sendSequence(pop());
                break;
            case YASS_SYS_EX_SEQ_DUMP:
                parseSequence(pop());
                break;
            default:
                sendError(YASS_SYS_EX_ERR_UNKNOWN);
                break;
        }
    }
}

void YASS_SYS_EX::setSenderCallback(void (*callback)(byte* addr, word size))
{
    senderCallback = callback;
}

void YASS_SYS_EX::sendSequence(byte seq_num)
{
    if(senderCallback)
    {
        if(seq_num < NB_SEQS)
        {
            openSysExMessage();
            
            push(YASS_SYS_EX_SEQ_DUMP);  
            push(seq_num);
            
            byte* data_ptr = seqsPtr[seq_num].getDataPointer();
            for(byte x = 0; x < YASS_SEQUENCE_DATA_SIZE; x++)
                push(*data_ptr++);
            
            closeAndSendSysExMessage();
        }
        else
            sendError(YASS_SYS_EX_ERR_BAD_PARAMETER);
    }
}

void YASS_SYS_EX::sendGlobal()
{
    if(senderCallback)
    {
            openSysExMessage();
            
            push(YASS_SYS_EX_GLOB_DUMP);  
            
            byte* data_ptr = configPtr->getDataPointer();
            for(byte x = 0; x < YASS_CONFIG_DATA_SIZE; x++)
                push(*data_ptr++);
            
            closeAndSendSysExMessage();
    }
}

void YASS_SYS_EX::sendAll()
{
    milestone = millis();
    state = STATE_GLOBAL;
}

void YASS_SYS_EX::parseSequence(byte seq_num)
{
    if(seq_num < NB_SEQS)
    {
        byte* data_ptr = seqsPtr[seq_num].getDataPointer();
        for(byte x = 0; x < YASS_SEQUENCE_DATA_SIZE; x++)
            *data_ptr++ = pop();
        sendAcknowledge();
    }
    else
        sendError(YASS_SYS_EX_ERR_BAD_PARAMETER);
}

void YASS_SYS_EX::parseGlobal()
{
    byte* data_ptr = configPtr->getDataPointer();
    for(byte x = 0; x < YASS_CONFIG_DATA_SIZE; x++)
        *data_ptr++ = pop();
    sendAcknowledge();
}

void YASS_SYS_EX::sendError(byte err_num)
{
    if(senderCallback)
    {
        openSysExMessage();
        
        push(YASS_SYS_EX_ERROR);  
        push(err_num);
        
        closeAndSendSysExMessage();
    }
}

void YASS_SYS_EX::sendAcknowledge()
{
    if(senderCallback)
    {
        openSysExMessage();
        
        push(YASS_SYS_EX_ACKNOWLEDGE);  
        
        closeAndSendSysExMessage();
    }
}

void YASS_SYS_EX::sequencer()
{
    if(state != STATE_READY)
        if(millis() >= milestone)
        {
            milestone += YASS_SYS_EX_DUMP_STEP_MSEC_DURATION;
            switch(state)
            {
                case STATE_GLOBAL:
                    sendGlobal();
                    state = STATE_SEQ_1;
                    break;
                case STATE_SEQ_1:
                    sendSequence(0);
                    state = STATE_SEQ_2;
                    break;
                case STATE_SEQ_2:
                    sendSequence(1);
                    state = STATE_SEQ_3;
                    break;
                case STATE_SEQ_3:
                    sendSequence(2);
                    state = STATE_SEQ_4;
                    break;
                case STATE_SEQ_4:
                    sendSequence(3);
                    state = STATE_SEQ_5;
                    break;
                case STATE_SEQ_5:
                    sendSequence(4);
                    state = STATE_READY;
                    break;
                default:
                    break;
            }
        }
}
