pfeuh/yass/yassKeyb.cpp

/*
 * file : yassKeyb.cpp
 * Copyright (c) pfeuh <ze.pfeuh@gmail>
 * All rights reserved.
 * 
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
 * You should have received a copy of the GNU General Public License
 * along with this program.  If not, see <http://www.gnu.org/licenses/>.
 */

#include "yassKeyb.h"

/*******************/
/* Private methods */
/*******************/

byte YASS_KEYB::getState(byte column, byte row)
{
    return (codes[column + row * nbColumns] & 0x80) == 0x80;
}

void YASS_KEYB::setState(byte column, byte row, byte state)
{
    if(state)
        codes[column + row * nbColumns] |= 0x80;
    else
        codes[column + row * nbColumns] &= 0x7f;
}

byte YASS_KEYB::getCode(byte column, byte row)
{
    return codes[column + row * nbColumns] & 0x7f;
}

/******************/
/* Public methods */
/******************/

YASS_KEYB::YASS_KEYB(int* column_pins, byte nb_columns, int* row_pins, byte nb_rows, char* _codes)
{
    columnPins = column_pins;
    nbColumns = nb_columns;
    rowPins = row_pins;
    nbRows = nb_rows;
    codes = _codes;
    pushHandler = NULL;
}

void YASS_KEYB::begin()
{
    for(byte x=0; x < nbColumns; x++)
    {
        pinMode(columnPins[x], INPUT_PULLUP);
    }
    for(byte x=0; x < nbRows; x++)
    {
        pinMode(rowPins[x], OUTPUT);
        digitalWrite(rowPins[x], 1);        
    }
    milestone = millis();
}

word YASS_KEYB::getPicture()
{
    word picture = 0x0000;
    for(byte y=0; y < nbRows; y++)
    {
        digitalWrite(rowPins[y], 0);        
        for(byte x=0; x < nbColumns; x++)
            picture = (picture >> 1) | (digitalRead(columnPins[x]) << 15);
        digitalWrite(rowPins[y], 1);
    }
    picture >>= 1;
    return picture ^ 0x7fff;
}

void YASS_KEYB::setPushHandler(YASS_KEYB_type_callback callback)
{
    pushHandler = callback;
}

byte YASS_KEYB::available()
{
    return _available;
}

byte YASS_KEYB::read()
{
    _available = 0;
    return buffer;
}

void YASS_KEYB::sequencer()
{
    byte current_state;
    byte old_state;
    for(byte y=0; y < nbRows; y++)
    {
        digitalWrite(rowPins[y], 0);        
        for(byte x=0; x < nbColumns; x++)
        {
            current_state = digitalRead(columnPins[x]);
            old_state = getState(x, y);
            if(!current_state)
            {
                if(old_state)
                {
                    if(millis() >= milestone)
                    {
                        if(pushHandler)
                            pushHandler(getCode(x, y));
                        else
                        {
                            _available = 1;
                            buffer = getCode(x, y);
                            
                        }
                        milestone += YASS_KEYB_DEBOUNCING_MSEC_DURATION;
                    }
                }
            }
            setState(x, y, current_state);
        }
        digitalWrite(rowPins[y], 1);
    }
}
