pfeuh/yass/(commit log)

2019-08-29 adds some documentation files
    [YASS_v3-B_Cu.gbr, YASS_v3-B_Mask.gbr, YASS_v3-B_SilkS.gbr, YASS_v3-F_Cu.gbr, YASS_v3-F_Mask.gbr, YASS_v3-F_SilkS.gbr, YASS_v3-NPTH.drl, YASS_v3-PTH.drl]
2019-08-29 Adds code for midi clock in Adds a bpm computation when using external clock
    [editFunctions.ods]
2019-08-31 Add part of sending/receiving global dump bug not fixed an another bug in displaying splash screen 'fact'
    [yass.h, yass.ino, yassKeyb.cpp, yassKeyb.h, yassSysEx.cpp]
2019-08-31 Adds specific folders in doc dedicated to yass front pannel
    [test.dxf]
2019-08-31 bug fixed: lower/upper case problem in filename yassSysEx
    [yass.h, yass.ino, yassBeeper.cpp, yassBeeper.h, yassComputeBeat.cpp, yassComputeBeat.h, yassConfig.cpp, yassConfig.h]
2019-09-01 front pannel black text on white board v.5
    [test.dxf]
2019-09-01 Adds file for laser cut machine
    [draftYass_v5_lasercut.dxf, draftYass_v5_lasercutSerigraphie.dxf]
2019-09-01 global config default setup done.
    [editFunctions.ods]
2019-09-03 Adds a maintenance mode and responds to remoted dump
    [editFunctions.ods]
2019-09-03 last commit before changing start stop continue behavior
    [editFunctions.ods, yassDetails.ods]
2019-09-04 key Continue replaced by ket Previous. Start Stop Continue assumed now by keys Start Stop
    [yass.h, yass.ino, yassKeyb.h, yassMaintenance.cpp, yassSequencer.cpp, yassSequencer.h]
2019-09-04 attempt to create a decent serigraphy
    [draftYass_v5_lasercut.dxf, draftYass_v5_lasercutSerigraphie.dxf]
2019-09-05 electronic board added
    [YASS_v2.kicad_pcb, YASS_v2.sch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]
2019-09-05 adds 3D objects
    [yassBoxV1.stl, yassBoxV2.stl, yassEntretoises.stl, yassFrontPannel.stl, yassTails.stl]
2019-09-05 another attempt to make a decent file for laser cut machine
2019-09-07 creration of decent bill of material
2019-09-08 modifications on 3D gears
    [CE3_yassBoxV2.3mf, yassBoxV2.stl, yassDetails.ods, yassFrontPannel.stl, yassFrontPannelV2.stl]
2019-09-09 new python script to generate files for lasercut machine
    [objectsCoordinates.kicad_pcb, yassDetails.ods]
2019-09-10 adds code to generate a csv file with coordinates of objects
    [coordinates.csv, yassDetails.ods]
2019-09-11 ajout du yassDevelopmentBook. Reéorganisation totale de l'utilisation de yassEditFsm. Renaming de plusieurs #define.
    [yassDetails.ods]
2019-09-18 some work on buttons logic & record mode
    [coordinates.csv]
2019-09-18 ajout panneau arriere teko avec les connecteurs
    [backPannelCoordinates.csv, coordinates.csv]
2019-09-28 adds a pattern to drillyassBackPannelTeko
2019-10-05 Adds face avant boite centrakor
    [yassFrontPannelCentrakor_coordinates.csv]
2019-10-06 Correction of centrakord board holes coordinates
    [yassFrontPannelCentrakor_coordinates.csv]
2019-10-09 proto console added
    [consoleProto_coordinates.csv, coordinates.csv]
2019-10-09 add encoder on consoleproto
    [consoleProto_coordinates.csv]
